revk/ESP32-Remote/PCB/Remote/README.md

# Remote

## Trademark

This project is subject to the licence in the LICENCE file, and even if that says it is an open source project, you cannot sell boards or cases bearing the Andrews & Arnold Ltd name, the A&A logo, the registered trademark AJK logo or other registered trademarks, or any GS1 allocated EANs/barcode assigned to Andrews & Arnold Ltd.

## PCB Designs

These files are for use with [KiCAD](https://www.kicad.org).

- [Remote](Remote.kicad_pro)

## 3D

3D case designs are normally automatically created from the PCB so as to ensure correct details and placement of apertures, etc.

- [blankplate](blankplate.stl)
- [Knob](Knob.stl)
- [Remote------](Remote------.stl)
- [Remote-----B](Remote-----B.stl)
- [Remote----I-](Remote----I-.stl)
- [Remote----IB](Remote----IB.stl)
- [Remote---C--](Remote---C--.stl)
- [Remote---C-B](Remote---C-B.stl)
- [Remote---CI-](Remote---CI-.stl)
- [Remote---CIB](Remote---CIB.stl)
- [Remote--D---](Remote--D---.stl)
- [Remote--D--B](Remote--D--B.stl)
- [Remote--D-I-](Remote--D-I-.stl)
- [Remote--D-IB](Remote--D-IB.stl)
- [Remote--DC--](Remote--DC--.stl)
- [Remote--DC-B](Remote--DC-B.stl)
- [Remote--DCI-](Remote--DCI-.stl)
- [Remote--DCIB](Remote--DCIB.stl)
- [Remote-Base](Remote-Base.stl)
- [Remote-P----](Remote-P----.stl)
- [Remote-P---B](Remote-P---B.stl)
- [Remote-P--I-](Remote-P--I-.stl)
- [Remote-P--IB](Remote-P--IB.stl)
- [Remote-P-C--](Remote-P-C--.stl)
- [Remote-P-C-B](Remote-P-C-B.stl)
- [Remote-P-CI-](Remote-P-CI-.stl)
- [Remote-P-CIB](Remote-P-CIB.stl)
- [Remote-PD---](Remote-PD---.stl)
- [Remote-PD--B](Remote-PD--B.stl)
- [Remote-PD-I-](Remote-PD-I-.stl)
- [Remote-PD-IB](Remote-PD-IB.stl)
- [Remote-PDC--](Remote-PDC--.stl)
- [Remote-PDC-B](Remote-PDC-B.stl)
- [Remote-PDCI-](Remote-PDCI-.stl)
- [Remote-PDCIB](Remote-PDCIB.stl)

## PCB Images

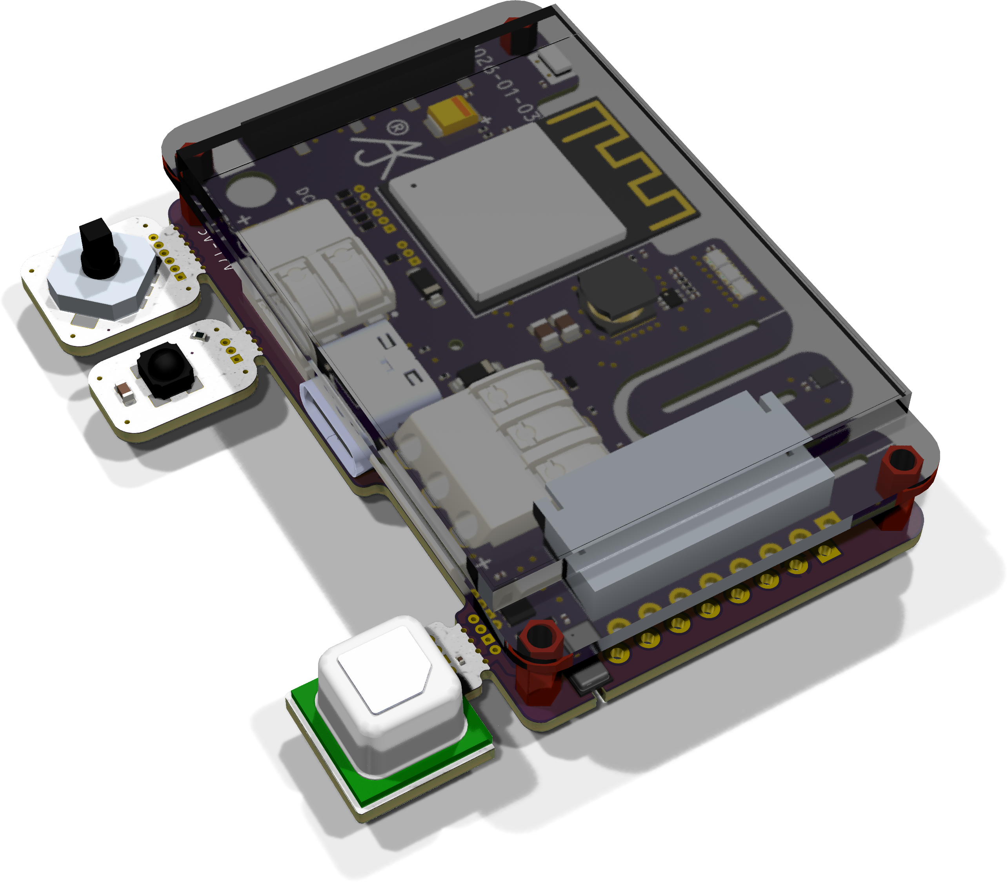
[picture p2: PCB/Remote/Remote-90.png]
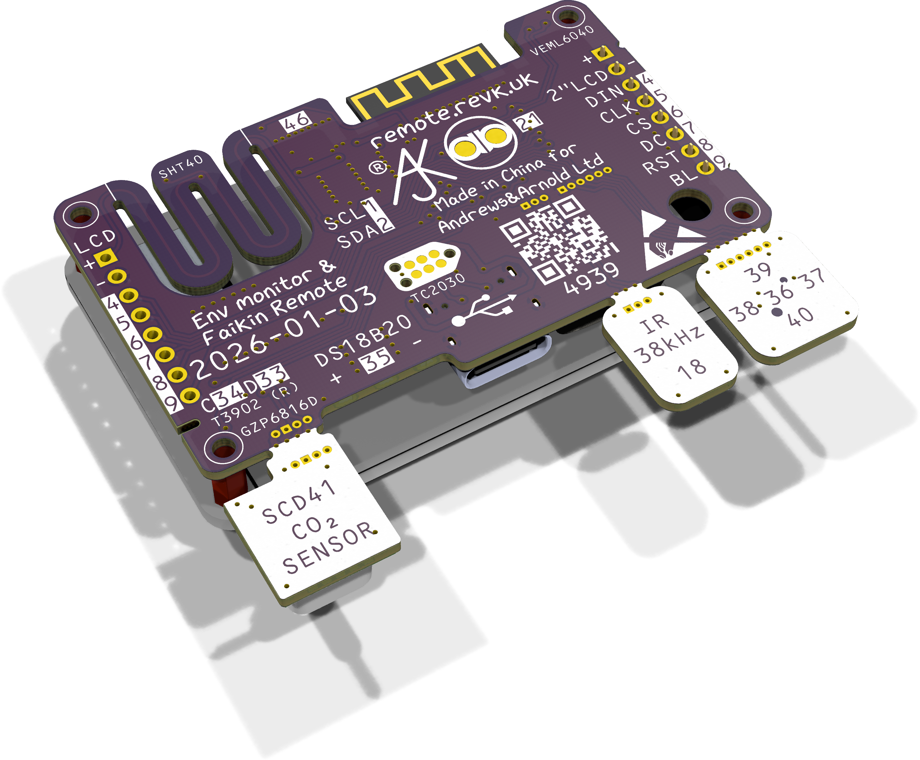
[picture p3: PCB/Remote/Remote-bottom.png]

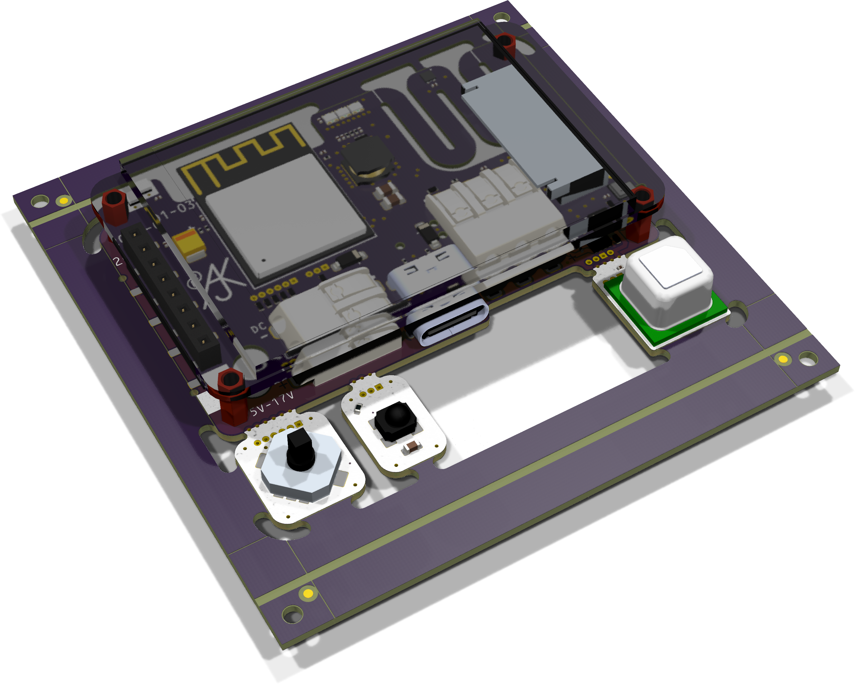
[picture p4: PCB/Remote/Remote-panel.png]
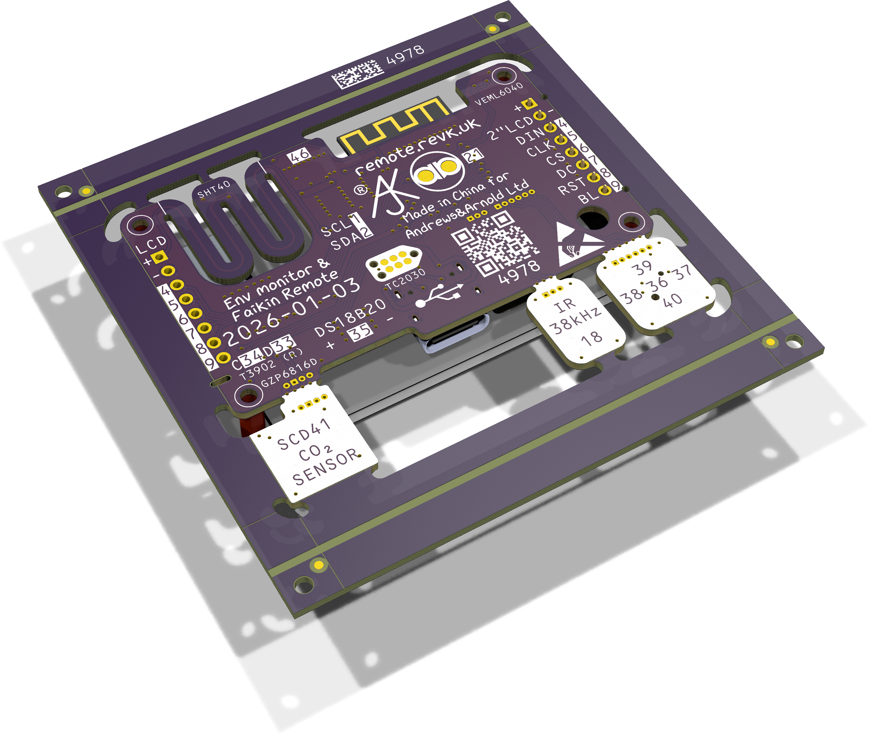
[picture p5: PCB/Remote/Remote-panel-bottom.png]


---

*Auto generated README.md 2026-01-03T10:27:57*
