revk/ESP32-Remote/PCB/Remote/blankplate.png

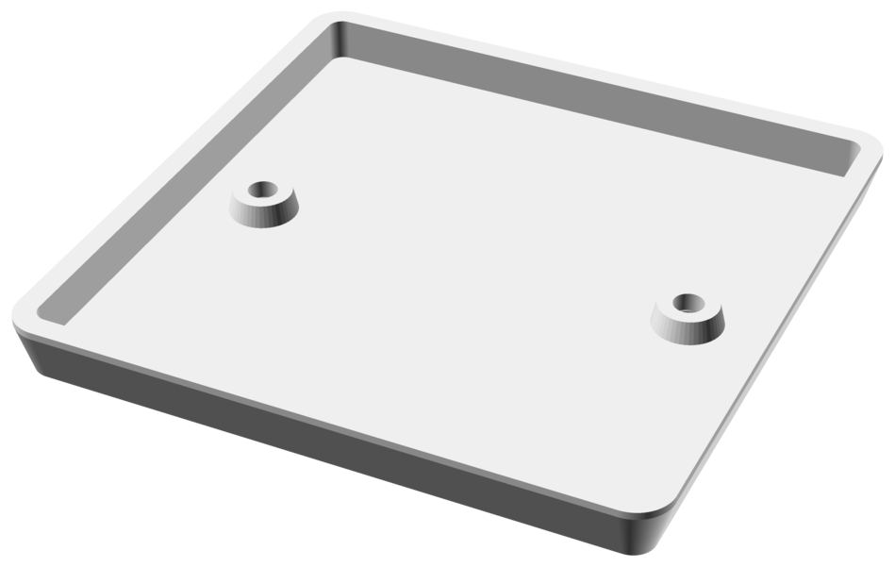
PCB/Remote/blankplate.png
