revk/ESP32-Remote/PCB/Remote/Knob.png

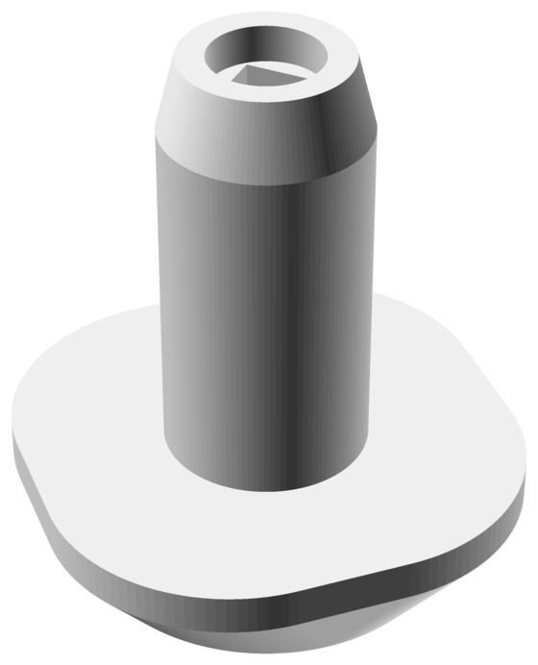
PCB/Remote/Knob.png
