revk/ESP32-Remote/PCB/Remote/Remote------.png

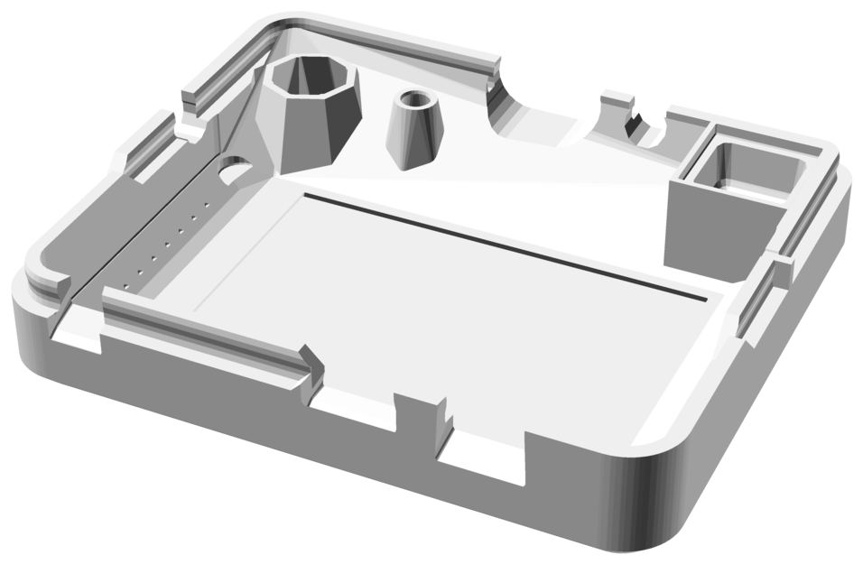
PCB/Remote/Remote------.png
