revk/ESP32-Remote/PCB/Remote/Remote-Base.png

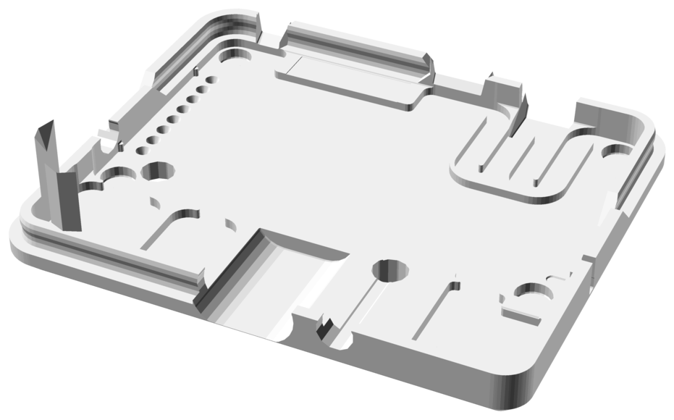
PCB/Remote/Remote-Base.png
