revk/ESP32-Remote/PCB/Remote/Remote-P----.png

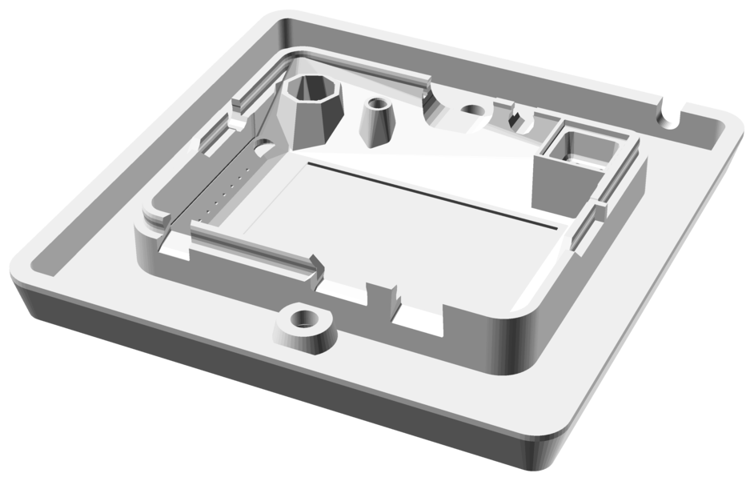
PCB/Remote/Remote-P----.png
