revk/ESP32-Remote/PCB/Remote/Remote-----B.stl

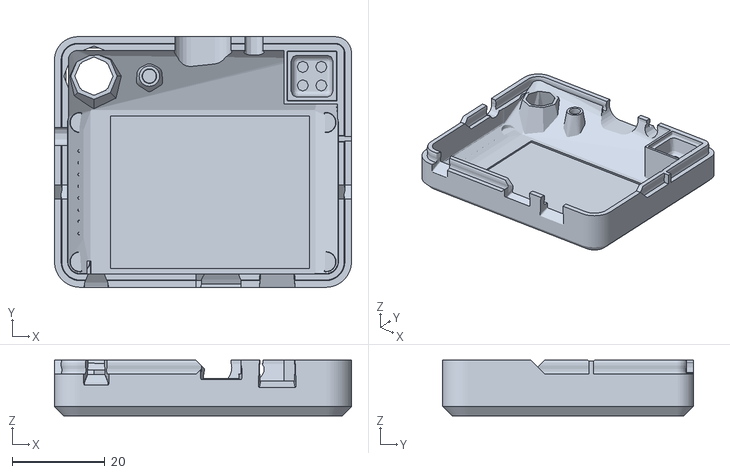
[picture p11: CAD file, 2026-01-03]
PCB/Remote/Remote-----B.stl
64.0 x 54.0 x 12.0
