revk/ESP32-Remote/PCB/Remote/Remote-P-C-B.stl

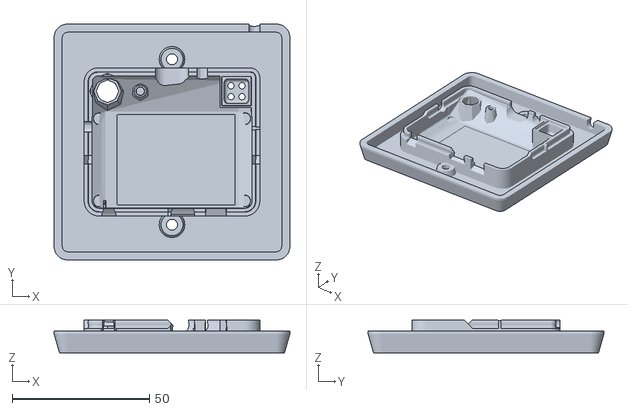
[picture p12: CAD file, 2026-01-03]
PCB/Remote/Remote-P-C-B.stl
86.0 x 86.0 x 12.0
