revk/ESP32-Remote/PCB/Remote/Remote--DCIB.stl

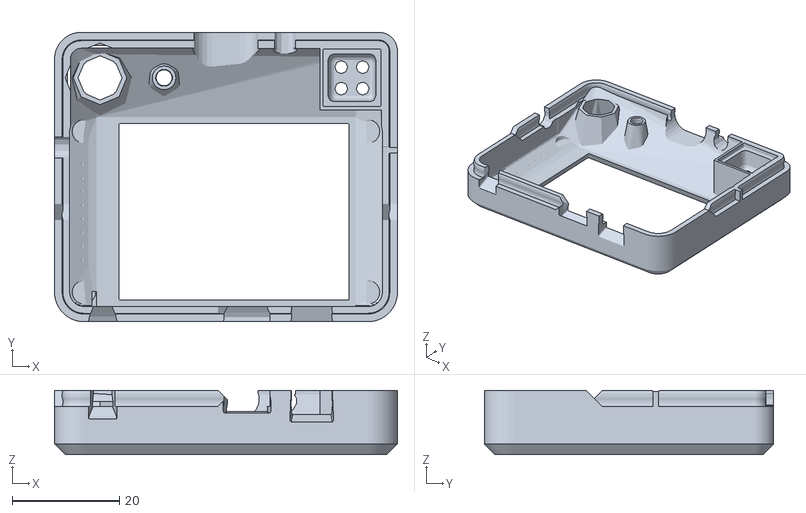
[picture p13: CAD file, 2026-01-03]
PCB/Remote/Remote--DCIB.stl
64.0 x 54.0 x 12.0
