revk/ESP32-Remote/PCB/Remote/Remote--D-I-.stl

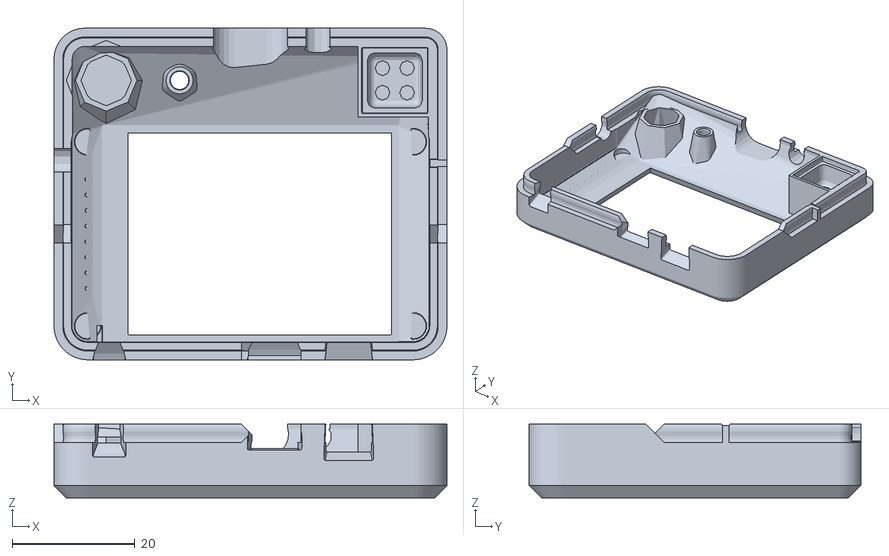
[picture p14: CAD file, 2026-01-03]
PCB/Remote/Remote--D-I-.stl
64.0 x 54.0 x 12.0
