revk/ESP32-Remote/PCB/Remote/Remote-PDC-B.stl

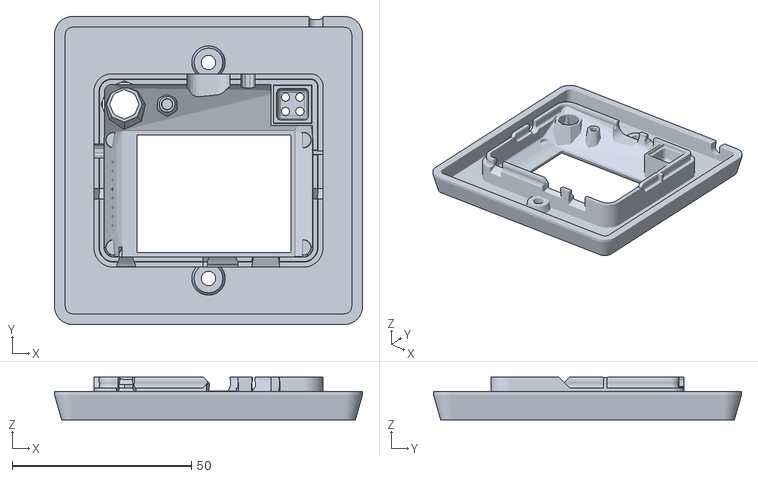
[picture p15: CAD file, 2026-01-03]
PCB/Remote/Remote-PDC-B.stl
86.0 x 86.0 x 12.0
