revk/ESP32-Remote/PCB/Remote/Remote-Base.stl

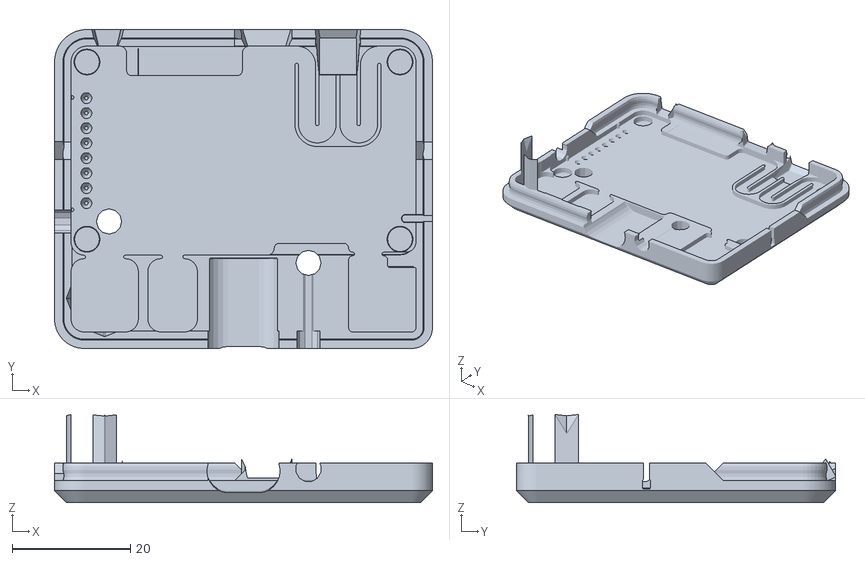
[picture p16: CAD file, 2026-01-03]
PCB/Remote/Remote-Base.stl
64.0 x 54.0 x 14.9
