revk/ESP32-Remote/PCB/Remote/Remote--DC--.stl

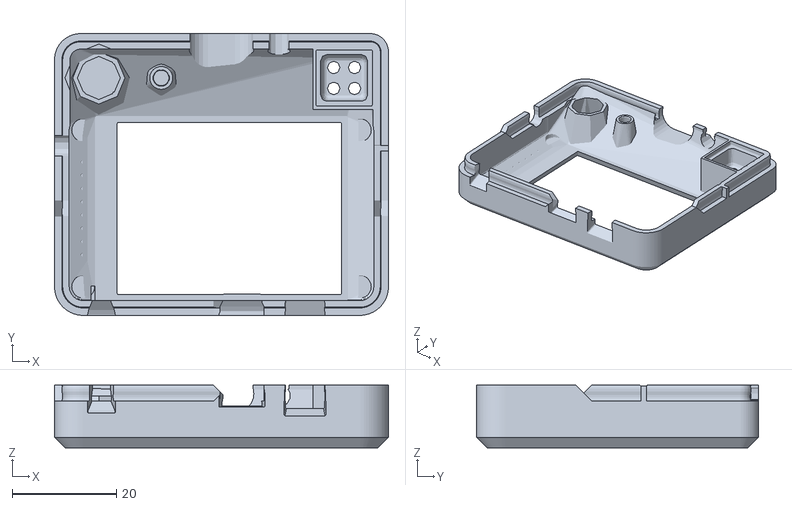
[picture p17: CAD file, 2026-01-03]
PCB/Remote/Remote--DC--.stl
64.0 x 54.0 x 12.0
