revk/ESP32-Remote/PCB/Remote/blankplate.stl

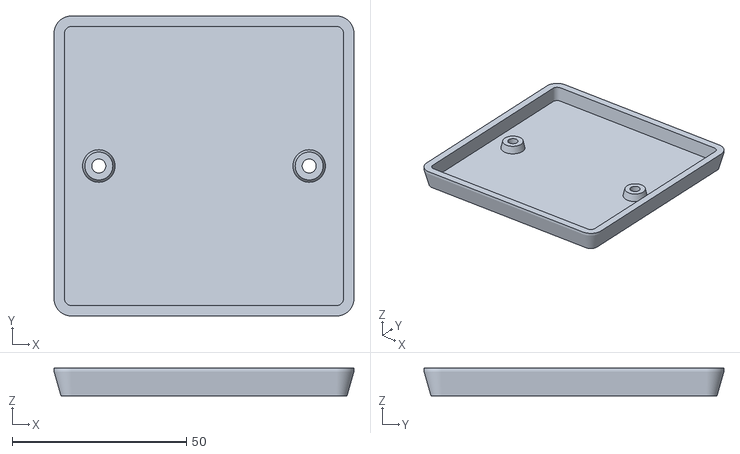
[picture p18: CAD file, 2025-08-25]
PCB/Remote/blankplate.stl
86.0 x 86.0 x 8.00
