revk/ESP32-Remote/PCB/Remote/Knob.stl

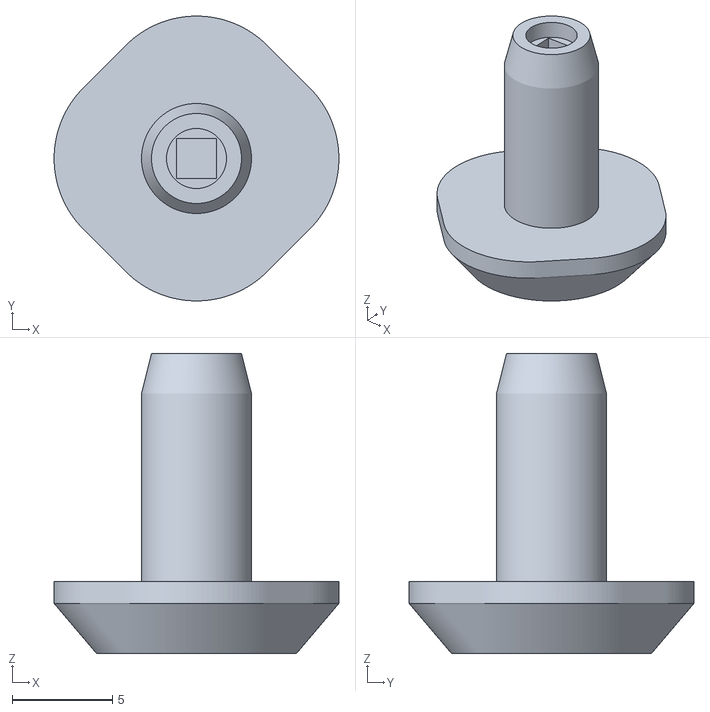
[picture p19: CAD file, 2025-08-25]
PCB/Remote/Knob.stl
14.2 x 14.2 x 15.0
