revk/ESP32-Remote/PCB/Remote/Knob.scad

$fn=120;
H=15;
m=0; // 0.3; // Zero for resin
difference()
{
    union()
    {
        hull()
        {
             cylinder(d=10,h=1);
             rotate([0,0,45])translate([0,0,3])minkowski()
             {
                cube([3,3,1],center=true);
                cylinder(r=5,h=0.1);
             }
        }
        cylinder(d=5.5,h=H-2);
        translate([0,0,H-2])cylinder(d2=4.5,d1=5.5,h=2);
    }
    translate([0,0,H-2])cube([2+m,2+m,4],center=true);
    translate([0,0,H-1])cylinder(d=3+m,h=2);
}
