revk/ESP32-Remote/PCB/Remote/Remote------.scad

// Generated case design for Remote/Remote.kicad_pcb
// By https://github.com/revk/PCBCase
// Generated 2026-01-03 10:10:24
// title:	Remote
// comment:	www.me.uk
// comment:	@TheRealRevK
// comment:	Adrian Kennard Andrews & Arnold Ltd
//

// Globals
margin=0.200000;
lip=3.000000;
lipa=0;
lipt=2;
casewall=3.000000;
casebottom=2.500000;
casetop=12.000000;
bottomthickness=0.000000;
topthickness=0.000000;
fit=0.000000;
snap=0.150000;
edge=2.000000;
pcbthickness=1.200000;
function pcbthickness()=1.200000;
nohull=false;
hullcap=1.000000;
hulledge=1.000000;
useredge=false;
datex=0.000000;
datey=0.000000;
datet=0.500000;
dateh=3.000000;
datea=0;
date="2026-01-03";
datef="OCRB";
logox=0.000000;
logoy=0.000000;
logot=0.500000;
logoh=10.000000;
logoa=0;
logo="A";
logof="AJK";
spacing=74.000000;
pcbwidth=58.000000;
function pcbwidth()=58.000000;
pcblength=48.000000;
function pcblength()=48.000000;
originx=100.000000;
originy=92.500000;

module outline(h=pcbthickness,r=0){linear_extrude(height=h)offset(r=r)polygon(points=[[20.000000,4.500000],[20.000000,14.500000],[20.036935,14.969303],[20.146831,15.427051],[20.326981,15.861971],[20.572949,16.263355],[20.878680,16.621320],[21.236645,16.927051],[21.638029,17.173019],[22.072949,17.353169],[22.530697,17.463065],[23.000000,17.500000],[26.500000,17.500000],[26.934120,17.462019],[27.355050,17.349232],[27.750000,17.165064],[28.106969,16.915111],[28.415111,16.606969],[28.665064,16.250000],[28.849232,15.855050],[28.962019,15.434120],[29.000000,15.000000],[29.000000,-15.500000],[28.962392,-15.833781],[28.851453,-16.150826],[28.672747,-16.435235],[28.435235,-16.672747],[28.150826,-16.851453],[27.833781,-16.962392],[27.500000,-17.000000],[23.700000,-17.000000],[23.450000,-17.066987],[23.266987,-17.250000],[23.200000,-17.500000],[23.266987,-17.750000],[23.450000,-17.933013],[23.700000,-18.000000],[23.891342,-18.038061],[24.053553,-18.146447],[24.161939,-18.308658],[24.200000,-18.500000],[24.200000,-19.500000],[24.346447,-19.853553],[24.700000,-20.000000],[29.000000,-20.000000],[29.000000,-30.000000],[28.961939,-30.191342],[28.853553,-30.353553],[28.691342,-30.461939],[28.500000,-30.500000],[18.500000,-30.500000],[18.308658,-30.461939],[18.146447,-30.353553],[18.038061,-30.191342],[18.000000,-30.000000],[18.000000,-18.500000],[18.038061,-18.308658],[18.146447,-18.146447],[18.308658,-18.038061],[18.500000,-18.000000],[18.750000,-17.933013],[18.933013,-17.750000],[19.000000,-17.500000],[18.933013,-17.250000],[18.750000,-17.066987],[18.500000,-17.000000],[18.308658,-16.961939],[18.146447,-16.853553],[18.038061,-16.691342],[18.000000,-16.500000],[17.923880,-16.117316],[17.707107,-15.792893],[17.382684,-15.576120],[17.000000,-15.500000],[6.000000,-15.500000],[5.617316,-15.576120],[5.292893,-15.792893],[5.076120,-16.117316],[5.000000,-16.500000],[4.965926,-16.758819],[4.866026,-17.000000],[4.707107,-17.207107],[4.500000,-17.366026],[4.258819,-17.465926],[4.000000,-17.500000],[-10.000000,-17.500000],[-10.250000,-17.566987],[-10.433013,-17.750000],[-10.500000,-18.000000],[-10.433013,-18.250000],[-10.250000,-18.433013],[-10.000000,-18.500000],[-9.609819,-18.538429],[-9.234633,-18.652241],[-8.888859,-18.837060],[-8.585786,-19.085786],[-8.337060,-19.388859],[-8.152241,-19.734633],[-8.038429,-20.109819],[-8.000000,-20.500000],[-8.000000,-28.500000],[-8.038429,-28.890181],[-8.152241,-29.265367],[-8.337060,-29.611141],[-8.585786,-29.914214],[-8.888859,-30.162940],[-9.234633,-30.347759],[-9.609819,-30.461571],[-10.000000,-30.500000],[-14.000000,-30.500000],[-14.390181,-30.461571],[-14.765367,-30.347759],[-15.111141,-30.162940],[-15.414214,-29.914214],[-15.662940,-29.611141],[-15.847759,-29.265367],[-15.961571,-28.890181],[-16.000000,-28.500000],[-16.000000,-20.500000],[-15.961571,-20.109819],[-15.847759,-19.734633],[-15.662940,-19.388859],[-15.414214,-19.085786],[-15.111141,-18.837060],[-14.765367,-18.652241],[-14.390181,-18.538429],[-14.000000,-18.500000],[-13.750000,-18.433013],[-13.566987,-18.250000],[-13.500000,-18.000000],[-13.566987,-17.750000],[-13.750000,-17.566987],[-14.000000,-17.500000],[-20.000000,-17.500000],[-20.250000,-17.566987],[-20.433013,-17.750000],[-20.500000,-18.000000],[-20.433013,-18.250000],[-20.250000,-18.433013],[-20.000000,-18.500000],[-19.609819,-18.538429],[-19.234633,-18.652241],[-18.888859,-18.837060],[-18.585786,-19.085786],[-18.337060,-19.388859],[-18.152241,-19.734633],[-18.038429,-20.109819],[-18.000000,-20.500000],[-18.000000,-28.500000],[-18.038429,-28.890181],[-18.152241,-29.265367],[-18.337060,-29.611141],[-18.585786,-29.914214],[-18.888859,-30.162940],[-19.234633,-30.347759],[-19.609819,-30.461571],[-20.000000,-30.500000],[-27.000000,-30.500000],[-27.390181,-30.461571],[-27.765367,-30.347759],[-28.111141,-30.162940],[-28.414214,-29.914214],[-28.662940,-29.611141],[-28.847759,-29.265367],[-28.961571,-28.890181],[-29.000000,-28.500000],[-29.000000,-20.500000],[-28.961571,-20.109819],[-28.847759,-19.734633],[-28.662940,-19.388859],[-28.414214,-19.085786],[-28.111141,-18.837060],[-27.765367,-18.652241],[-27.390181,-18.538429],[-27.000000,-18.500000],[-26.750000,-18.433013],[-26.566987,-18.250000],[-26.500000,-18.000000],[-26.566987,-17.750000],[-26.750000,-17.566987],[-27.000000,-17.500000],[-27.390181,-17.461571],[-27.765367,-17.347759],[-28.111141,-17.162940],[-28.414214,-16.914214],[-28.662940,-16.611141],[-28.847759,-16.265367],[-28.961571,-15.890181],[-29.000000,-15.500000],[-29.000000,-10.500000],[-28.750000,-10.433013],[-28.566987,-10.250000],[-28.500000,-10.000000],[-28.566987,-9.750000],[-28.750000,-9.566987],[-29.000000,-9.500000],[-29.000000,8.500000],[-28.750000,8.566987],[-28.566987,8.750000],[-28.500000,9.000000],[-28.566987,9.250000],[-28.750000,9.433013],[-29.000000,9.500000],[-29.000000,15.000000],[-28.962019,15.434120],[-28.849232,15.855050],[-28.665064,16.250000],[-28.415111,16.606969],[-28.106969,16.915111],[-27.750000,17.165064],[-27.355050,17.349232],[-26.934120,17.462019],[-26.500000,17.500000],[-21.000000,17.500000],[-20.741181,17.465926],[-20.500000,17.366026],[-20.292893,17.207107],[-20.133974,17.000000],[-20.034074,16.758819],[-20.000000,16.500000],[-20.000000,13.500000],[-19.923880,13.117316],[-19.707107,12.792893],[-19.382684,12.576120],[-19.000000,12.500000],[-1.000000,12.500000],[-0.617316,12.576120],[-0.292893,12.792893],[-0.076120,13.117316],[0.000000,13.500000],[0.000000,16.500000],[0.034074,16.758819],[0.133974,17.000000],[0.292893,17.207107],[0.500000,17.366026],[0.741181,17.465926],[1.000000,17.500000],[9.000000,17.500000],[9.469303,17.463065],[9.927051,17.353169],[10.361971,17.173019],[10.763355,16.927051],[11.121320,16.621320],[11.427051,16.263355],[11.673019,15.861971],[11.853169,15.427051],[11.963065,14.969303],[12.000000,14.500000],[12.000000,4.500000],[12.066987,4.250000],[12.250000,4.066987],[12.500000,4.000000],[12.750000,4.066987],[12.933013,4.250000],[13.000000,4.500000],[13.000000,15.500000],[13.038429,15.890181],[13.152241,16.265367],[13.337060,16.611141],[13.585786,16.914214],[13.888859,17.162940],[14.234633,17.347759],[14.609819,17.461571],[15.000000,17.500000],[17.000000,17.500000],[17.390181,17.461571],[17.765367,17.347759],[18.111141,17.162940],[18.414214,16.914214],[18.662940,16.611141],[18.847759,16.265367],[18.961571,15.890181],[19.000000,15.500000],[19.000000,4.500000],[19.066987,4.250000],[19.250000,4.066987],[19.500000,4.000000],[19.750000,4.066987],[19.933013,4.250000],[22.500000,4.500000],[22.500000,14.500000],[22.538060,14.691342],[22.646447,14.853553],[22.808658,14.961940],[23.000000,15.000000],[23.191342,14.961940],[23.353553,14.853553],[23.461940,14.691342],[23.500000,14.500000],[23.500000,4.500000],[23.465779,3.977895],[23.363703,3.464724],[23.195518,2.969266],[22.964101,2.500000],[22.673413,2.064954],[22.328427,1.671573],[21.935046,1.326587],[21.500000,1.035899],[21.030734,0.804482],[20.535276,0.636297],[20.022105,0.534221],[19.500000,0.500000],[12.500000,0.500000],[11.977895,0.534221],[11.464724,0.636297],[10.969266,0.804482],[10.500000,1.035899],[10.064954,1.326587],[9.671573,1.671573],[9.326587,2.064954],[9.035899,2.500000],[8.804482,2.969266],[8.636297,3.464724],[8.534221,3.977895],[8.500000,4.500000],[8.500000,14.500000],[8.538060,14.691342],[8.646447,14.853553],[8.808658,14.961940],[9.000000,15.000000],[9.191342,14.961940],[9.353553,14.853553],[9.461940,14.691342],[9.500000,14.500000],[9.500000,4.500000],[9.545577,3.979055],[9.680922,3.473940],[9.901924,3.000000],[10.201867,2.571637],[10.571637,2.201867],[11.000000,1.901924],[11.473940,1.680922],[11.979055,1.545577],[12.500000,1.500000],[13.020945,1.545577],[13.526060,1.680922],[14.000000,1.901924],[14.428363,2.201867],[14.798133,2.571637],[15.098076,3.000000],[15.319078,3.473940],[15.454423,3.979055],[15.500000,4.500000],[15.500000,13.000000],[15.538060,13.191342],[15.646447,13.353553],[15.808658,13.461940],[16.000000,13.500000],[16.191342,13.461940],[16.353553,13.353553],[16.461940,13.191342],[16.500000,13.000000],[16.500000,4.500000],[16.545577,3.979055],[16.680922,3.473940],[16.901924,3.000000],[17.201867,2.571637],[17.571637,2.201867],[18.000000,1.901924],[18.473940,1.680922],[18.979055,1.545577],[19.500000,1.500000],[20.020945,1.545577],[20.526060,1.680922],[21.000000,1.901924],[21.428363,2.201867],[21.798133,2.571637],[22.098076,3.000000],[22.319078,3.473940],[22.454423,3.979055],[25.500000,15.000000],[25.534074,15.258819],[25.633975,15.500000],[25.792893,15.707107],[26.000000,15.866025],[26.241181,15.965926],[26.500000,16.000000],[26.758819,15.965926],[27.000000,15.866025],[27.207107,15.707107],[27.366025,15.500000],[27.465926,15.258819],[27.500000,15.000000],[27.465926,14.741181],[27.366025,14.500000],[27.207107,14.292893],[27.000000,14.133975],[26.758819,14.034074],[26.500000,14.000000],[26.241181,14.034074],[26.000000,14.133975],[25.792893,14.292893],[25.633975,14.500000],[25.534074,14.741181],[25.500000,-15.000000],[25.534074,-14.741181],[25.633975,-14.500000],[25.792893,-14.292893],[26.000000,-14.133975],[26.241181,-14.034074],[26.500000,-14.000000],[26.758819,-14.034074],[27.000000,-14.133975],[27.207107,-14.292893],[27.366025,-14.500000],[27.465926,-14.741181],[27.500000,-15.000000],[27.465926,-15.258819],[27.366025,-15.500000],[27.207107,-15.707107],[27.000000,-15.866025],[26.758819,-15.965926],[26.500000,-16.000000],[26.241181,-15.965926],[26.000000,-15.866025],[25.792893,-15.707107],[25.633975,-15.500000],[25.534074,-15.258819],[-20.750000,-12.000000],[-20.788429,-12.390181],[-20.902241,-12.765367],[-21.087061,-13.111140],[-21.335786,-13.414214],[-21.638860,-13.662939],[-21.984633,-13.847759],[-22.359819,-13.961571],[-22.750000,-14.000000],[-23.140181,-13.961571],[-23.515367,-13.847759],[-23.861140,-13.662939],[-24.164214,-13.414214],[-24.412939,-13.111140],[-24.597759,-12.765367],[-24.711571,-12.390181],[-24.750000,-12.000000],[-24.711571,-11.609819],[-24.597759,-11.234633],[-24.412939,-10.888860],[-24.164214,-10.585786],[-23.861140,-10.337061],[-23.515367,-10.152241],[-23.140181,-10.038429],[-22.750000,-10.000000],[-22.359819,-10.038429],[-21.984633,-10.152241],[-21.638860,-10.337061],[-21.335786,-10.585786],[-21.087061,-10.888860],[-20.902241,-11.234633],[-20.788429,-11.609819],[-25.500000,-15.000000],[-25.534074,-15.258819],[-25.633975,-15.500000],[-25.792893,-15.707107],[-26.000000,-15.866025],[-26.241181,-15.965926],[-26.500000,-16.000000],[-26.758819,-15.965926],[-27.000000,-15.866025],[-27.207107,-15.707107],[-27.366025,-15.500000],[-27.465926,-15.258819],[-27.500000,-15.000000],[-27.465926,-14.741181],[-27.366025,-14.500000],[-27.207107,-14.292893],[-27.000000,-14.133975],[-26.758819,-14.034074],[-26.500000,-14.000000],[-26.241181,-14.034074],[-26.000000,-14.133975],[-25.792893,-14.292893],[-25.633975,-14.500000],[-25.534074,-14.741181],[-25.500000,15.000000],[-25.534074,14.741181],[-25.633975,14.500000],[-25.792893,14.292893],[-26.000000,14.133975],[-26.241181,14.034074],[-26.500000,14.000000],[-26.758819,14.034074],[-27.000000,14.133975],[-27.207107,14.292893],[-27.366025,14.500000],[-27.465926,14.741181],[-27.500000,15.000000],[-27.465926,15.258819],[-27.366025,15.500000],[-27.207107,15.707107],[-27.000000,15.866025],[-26.758819,15.965926],[-26.500000,16.000000],[-26.241181,15.965926],[-26.000000,15.866025],[-25.792893,15.707107],[-25.633975,15.500000],[-25.534074,15.258819]],paths=[[0,1,2,3,4,5,6,7,8,9,10,11,12,13,14,15,16,17,18,19,20,21,22,23,24,25,26,27,28,29,30,31,32,33,34,35,36,37,38,39,40,41,42,43,44,45,46,47,48,49,50,51,52,53,54,55,56,57,58,59,60,61,62,63,64,65,66,67,68,69,70,71,72,73,74,75,76,77,78,79,80,81,82,83,84,85,86,87,88,89,90,91,92,93,94,95,96,97,98,99,100,101,102,103,104,105,106,107,108,109,110,111,112,113,114,115,116,117,118,119,120,121,122,123,124,125,126,127,128,129,130,131,132,133,134,135,136,137,138,139,140,141,142,143,144,145,146,147,148,149,150,151,152,153,154,155,156,157,158,159,160,161,162,163,164,165,166,167,168,169,170,171,172,173,174,175,176,177,178,179,180,181,182,183,184,185,186,187,188,189,190,191,192,193,194,195,196,197,198,199,200,201,202,203,204,205,206,207,208,209,210,211,212,213,214,215,216,217,218,219,220,221,222,223,224,225,226,227,228,229,230,231,232,233,234,235,236,237,238,239,240,241,242,243,244,245,246,247,248,249,250,251,252,253,254,255,256,257,258,259,260,261,262,263,264,265,266,267,268,269,270,271,272,273,274,275,276,277,278],[279,280,281,282,283,284,285,286,287,288,289,290,291,292,293,294,295,296,297,298,299,300,301,302,303,304,305,306,307,308,309,310,311,312,313,314,315,316,317,318,319,320,321,322,323,324,325,326,327,328,329,330,331,332,333,334,335,336,337,338,339,340,341,342,343,344,345,346,347,348,349,350,351,352,353,354,355,356,357,358,359,360,361,362,363,364,365,366,367,368,369],[370,371,372,373,374,375,376,377,378,379,380,381,382,383,384,385,386,387,388,389,390,391,392,393],[394,395,396,397,398,399,400,401,402,403,404,405,406,407,408,409,410,411,412,413,414,415,416,417],[418,419,420,421,422,423,424,425,426,427,428,429,430,431,432,433,434,435,436,437,438,439,440,441,442,443,444,445,446,447,448,449],[450,451,452,453,454,455,456,457,458,459,460,461,462,463,464,465,466,467,468,469,470,471,472,473],[474,475,476,477,478,479,480,481,482,483,484,485,486,487,488,489,490,491,492,493,494,495,496,497]]);}

module pcb(h=pcbthickness,r=0){linear_extrude(height=h)offset(r=r)polygon(points=[[20.000000,4.500000],[20.000000,14.500000],[20.036935,14.969303],[20.146831,15.427051],[20.326981,15.861971],[20.572949,16.263355],[20.878680,16.621320],[21.236645,16.927051],[21.638029,17.173019],[22.072949,17.353169],[22.530697,17.463065],[23.000000,17.500000],[26.500000,17.500000],[26.934120,17.462019],[27.355050,17.349232],[27.750000,17.165064],[28.106969,16.915111],[28.415111,16.606969],[28.665064,16.250000],[28.849232,15.855050],[28.962019,15.434120],[29.000000,15.000000],[29.000000,-15.500000],[28.962392,-15.833781],[28.851453,-16.150826],[28.672747,-16.435235],[28.435235,-16.672747],[28.150826,-16.851453],[27.833781,-16.962392],[27.500000,-17.000000],[23.700000,-17.000000],[23.450000,-17.066987],[23.266987,-17.250000],[23.200000,-17.500000],[23.266987,-17.750000],[23.450000,-17.933013],[23.700000,-18.000000],[23.891342,-18.038061],[24.053553,-18.146447],[24.161939,-18.308658],[24.200000,-18.500000],[24.200000,-19.500000],[24.346447,-19.853553],[24.700000,-20.000000],[29.000000,-20.000000],[29.000000,-30.000000],[28.961939,-30.191342],[28.853553,-30.353553],[28.691342,-30.461939],[28.500000,-30.500000],[18.500000,-30.500000],[18.308658,-30.461939],[18.146447,-30.353553],[18.038061,-30.191342],[18.000000,-30.000000],[18.000000,-18.500000],[18.038061,-18.308658],[18.146447,-18.146447],[18.308658,-18.038061],[18.500000,-18.000000],[18.750000,-17.933013],[18.933013,-17.750000],[19.000000,-17.500000],[18.933013,-17.250000],[18.750000,-17.066987],[18.500000,-17.000000],[18.308658,-16.961939],[18.146447,-16.853553],[18.038061,-16.691342],[18.000000,-16.500000],[17.923880,-16.117316],[17.707107,-15.792893],[17.382684,-15.576120],[17.000000,-15.500000],[6.000000,-15.500000],[5.617316,-15.576120],[5.292893,-15.792893],[5.076120,-16.117316],[5.000000,-16.500000],[4.965926,-16.758819],[4.866026,-17.000000],[4.707107,-17.207107],[4.500000,-17.366026],[4.258819,-17.465926],[4.000000,-17.500000],[-10.000000,-17.500000],[-10.250000,-17.566987],[-10.433013,-17.750000],[-10.500000,-18.000000],[-10.433013,-18.250000],[-10.250000,-18.433013],[-10.000000,-18.500000],[-9.609819,-18.538429],[-9.234633,-18.652241],[-8.888859,-18.837060],[-8.585786,-19.085786],[-8.337060,-19.388859],[-8.152241,-19.734633],[-8.038429,-20.109819],[-8.000000,-20.500000],[-8.000000,-28.500000],[-8.038429,-28.890181],[-8.152241,-29.265367],[-8.337060,-29.611141],[-8.585786,-29.914214],[-8.888859,-30.162940],[-9.234633,-30.347759],[-9.609819,-30.461571],[-10.000000,-30.500000],[-14.000000,-30.500000],[-14.390181,-30.461571],[-14.765367,-30.347759],[-15.111141,-30.162940],[-15.414214,-29.914214],[-15.662940,-29.611141],[-15.847759,-29.265367],[-15.961571,-28.890181],[-16.000000,-28.500000],[-16.000000,-20.500000],[-15.961571,-20.109819],[-15.847759,-19.734633],[-15.662940,-19.388859],[-15.414214,-19.085786],[-15.111141,-18.837060],[-14.765367,-18.652241],[-14.390181,-18.538429],[-14.000000,-18.500000],[-13.750000,-18.433013],[-13.566987,-18.250000],[-13.500000,-18.000000],[-13.566987,-17.750000],[-13.750000,-17.566987],[-14.000000,-17.500000],[-20.000000,-17.500000],[-20.250000,-17.566987],[-20.433013,-17.750000],[-20.500000,-18.000000],[-20.433013,-18.250000],[-20.250000,-18.433013],[-20.000000,-18.500000],[-19.609819,-18.538429],[-19.234633,-18.652241],[-18.888859,-18.837060],[-18.585786,-19.085786],[-18.337060,-19.388859],[-18.152241,-19.734633],[-18.038429,-20.109819],[-18.000000,-20.500000],[-18.000000,-28.500000],[-18.038429,-28.890181],[-18.152241,-29.265367],[-18.337060,-29.611141],[-18.585786,-29.914214],[-18.888859,-30.162940],[-19.234633,-30.347759],[-19.609819,-30.461571],[-20.000000,-30.500000],[-27.000000,-30.500000],[-27.390181,-30.461571],[-27.765367,-30.347759],[-28.111141,-30.162940],[-28.414214,-29.914214],[-28.662940,-29.611141],[-28.847759,-29.265367],[-28.961571,-28.890181],[-29.000000,-28.500000],[-29.000000,-20.500000],[-28.961571,-20.109819],[-28.847759,-19.734633],[-28.662940,-19.388859],[-28.414214,-19.085786],[-28.111141,-18.837060],[-27.765367,-18.652241],[-27.390181,-18.538429],[-27.000000,-18.500000],[-26.750000,-18.433013],[-26.566987,-18.250000],[-26.500000,-18.000000],[-26.566987,-17.750000],[-26.750000,-17.566987],[-27.000000,-17.500000],[-27.390181,-17.461571],[-27.765367,-17.347759],[-28.111141,-17.162940],[-28.414214,-16.914214],[-28.662940,-16.611141],[-28.847759,-16.265367],[-28.961571,-15.890181],[-29.000000,-15.500000],[-29.000000,-10.500000],[-28.750000,-10.433013],[-28.566987,-10.250000],[-28.500000,-10.000000],[-28.566987,-9.750000],[-28.750000,-9.566987],[-29.000000,-9.500000],[-29.000000,8.500000],[-28.750000,8.566987],[-28.566987,8.750000],[-28.500000,9.000000],[-28.566987,9.250000],[-28.750000,9.433013],[-29.000000,9.500000],[-29.000000,15.000000],[-28.962019,15.434120],[-28.849232,15.855050],[-28.665064,16.250000],[-28.415111,16.606969],[-28.106969,16.915111],[-27.750000,17.165064],[-27.355050,17.349232],[-26.934120,17.462019],[-26.500000,17.500000],[-21.000000,17.500000],[-20.741181,17.465926],[-20.500000,17.366026],[-20.292893,17.207107],[-20.133974,17.000000],[-20.034074,16.758819],[-20.000000,16.500000],[-20.000000,13.500000],[-19.923880,13.117316],[-19.707107,12.792893],[-19.382684,12.576120],[-19.000000,12.500000],[-1.000000,12.500000],[-0.617316,12.576120],[-0.292893,12.792893],[-0.076120,13.117316],[0.000000,13.500000],[0.000000,16.500000],[0.034074,16.758819],[0.133974,17.000000],[0.292893,17.207107],[0.500000,17.366026],[0.741181,17.465926],[1.000000,17.500000],[9.000000,17.500000],[9.469303,17.463065],[9.927051,17.353169],[10.361971,17.173019],[10.763355,16.927051],[11.121320,16.621320],[11.427051,16.263355],[11.673019,15.861971],[11.853169,15.427051],[11.963065,14.969303],[12.000000,14.500000],[12.000000,4.500000],[12.066987,4.250000],[12.250000,4.066987],[12.500000,4.000000],[12.750000,4.066987],[12.933013,4.250000],[13.000000,4.500000],[13.000000,15.500000],[13.038429,15.890181],[13.152241,16.265367],[13.337060,16.611141],[13.585786,16.914214],[13.888859,17.162940],[14.234633,17.347759],[14.609819,17.461571],[15.000000,17.500000],[17.000000,17.500000],[17.390181,17.461571],[17.765367,17.347759],[18.111141,17.162940],[18.414214,16.914214],[18.662940,16.611141],[18.847759,16.265367],[18.961571,15.890181],[19.000000,15.500000],[19.000000,4.500000],[19.066987,4.250000],[19.250000,4.066987],[19.500000,4.000000],[19.750000,4.066987],[19.933013,4.250000],[22.500000,4.500000],[22.500000,14.500000],[22.538060,14.691342],[22.646447,14.853553],[22.808658,14.961940],[23.000000,15.000000],[23.191342,14.961940],[23.353553,14.853553],[23.461940,14.691342],[23.500000,14.500000],[23.500000,4.500000],[23.465779,3.977895],[23.363703,3.464724],[23.195518,2.969266],[22.964101,2.500000],[22.673413,2.064954],[22.328427,1.671573],[21.935046,1.326587],[21.500000,1.035899],[21.030734,0.804482],[20.535276,0.636297],[20.022105,0.534221],[19.500000,0.500000],[12.500000,0.500000],[11.977895,0.534221],[11.464724,0.636297],[10.969266,0.804482],[10.500000,1.035899],[10.064954,1.326587],[9.671573,1.671573],[9.326587,2.064954],[9.035899,2.500000],[8.804482,2.969266],[8.636297,3.464724],[8.534221,3.977895],[8.500000,4.500000],[8.500000,14.500000],[8.538060,14.691342],[8.646447,14.853553],[8.808658,14.961940],[9.000000,15.000000],[9.191342,14.961940],[9.353553,14.853553],[9.461940,14.691342],[9.500000,14.500000],[9.500000,4.500000],[9.545577,3.979055],[9.680922,3.473940],[9.901924,3.000000],[10.201867,2.571637],[10.571637,2.201867],[11.000000,1.901924],[11.473940,1.680922],[11.979055,1.545577],[12.500000,1.500000],[13.020945,1.545577],[13.526060,1.680922],[14.000000,1.901924],[14.428363,2.201867],[14.798133,2.571637],[15.098076,3.000000],[15.319078,3.473940],[15.454423,3.979055],[15.500000,4.500000],[15.500000,13.000000],[15.538060,13.191342],[15.646447,13.353553],[15.808658,13.461940],[16.000000,13.500000],[16.191342,13.461940],[16.353553,13.353553],[16.461940,13.191342],[16.500000,13.000000],[16.500000,4.500000],[16.545577,3.979055],[16.680922,3.473940],[16.901924,3.000000],[17.201867,2.571637],[17.571637,2.201867],[18.000000,1.901924],[18.473940,1.680922],[18.979055,1.545577],[19.500000,1.500000],[20.020945,1.545577],[20.526060,1.680922],[21.000000,1.901924],[21.428363,2.201867],[21.798133,2.571637],[22.098076,3.000000],[22.319078,3.473940],[22.454423,3.979055],[25.500000,15.000000],[25.534074,15.258819],[25.633975,15.500000],[25.792893,15.707107],[26.000000,15.866025],[26.241181,15.965926],[26.500000,16.000000],[26.758819,15.965926],[27.000000,15.866025],[27.207107,15.707107],[27.366025,15.500000],[27.465926,15.258819],[27.500000,15.000000],[27.465926,14.741181],[27.366025,14.500000],[27.207107,14.292893],[27.000000,14.133975],[26.758819,14.034074],[26.500000,14.000000],[26.241181,14.034074],[26.000000,14.133975],[25.792893,14.292893],[25.633975,14.500000],[25.534074,14.741181],[25.500000,-15.000000],[25.534074,-14.741181],[25.633975,-14.500000],[25.792893,-14.292893],[26.000000,-14.133975],[26.241181,-14.034074],[26.500000,-14.000000],[26.758819,-14.034074],[27.000000,-14.133975],[27.207107,-14.292893],[27.366025,-14.500000],[27.465926,-14.741181],[27.500000,-15.000000],[27.465926,-15.258819],[27.366025,-15.500000],[27.207107,-15.707107],[27.000000,-15.866025],[26.758819,-15.965926],[26.500000,-16.000000],[26.241181,-15.965926],[26.000000,-15.866025],[25.792893,-15.707107],[25.633975,-15.500000],[25.534074,-15.258819],[-20.750000,-12.000000],[-20.788429,-12.390181],[-20.902241,-12.765367],[-21.087061,-13.111140],[-21.335786,-13.414214],[-21.638860,-13.662939],[-21.984633,-13.847759],[-22.359819,-13.961571],[-22.750000,-14.000000],[-23.140181,-13.961571],[-23.515367,-13.847759],[-23.861140,-13.662939],[-24.164214,-13.414214],[-24.412939,-13.111140],[-24.597759,-12.765367],[-24.711571,-12.390181],[-24.750000,-12.000000],[-24.711571,-11.609819],[-24.597759,-11.234633],[-24.412939,-10.888860],[-24.164214,-10.585786],[-23.861140,-10.337061],[-23.515367,-10.152241],[-23.140181,-10.038429],[-22.750000,-10.000000],[-22.359819,-10.038429],[-21.984633,-10.152241],[-21.638860,-10.337061],[-21.335786,-10.585786],[-21.087061,-10.888860],[-20.902241,-11.234633],[-20.788429,-11.609819],[-25.500000,-15.000000],[-25.534074,-15.258819],[-25.633975,-15.500000],[-25.792893,-15.707107],[-26.000000,-15.866025],[-26.241181,-15.965926],[-26.500000,-16.000000],[-26.758819,-15.965926],[-27.000000,-15.866025],[-27.207107,-15.707107],[-27.366025,-15.500000],[-27.465926,-15.258819],[-27.500000,-15.000000],[-27.465926,-14.741181],[-27.366025,-14.500000],[-27.207107,-14.292893],[-27.000000,-14.133975],[-26.758819,-14.034074],[-26.500000,-14.000000],[-26.241181,-14.034074],[-26.000000,-14.133975],[-25.792893,-14.292893],[-25.633975,-14.500000],[-25.534074,-14.741181],[-25.500000,15.000000],[-25.534074,14.741181],[-25.633975,14.500000],[-25.792893,14.292893],[-26.000000,14.133975],[-26.241181,14.034074],[-26.500000,14.000000],[-26.758819,14.034074],[-27.000000,14.133975],[-27.207107,14.292893],[-27.366025,14.500000],[-27.465926,14.741181],[-27.500000,15.000000],[-27.465926,15.258819],[-27.366025,15.500000],[-27.207107,15.707107],[-27.000000,15.866025],[-26.758819,15.965926],[-26.500000,16.000000],[-26.241181,15.965926],[-26.000000,15.866025],[-25.792893,15.707107],[-25.633975,15.500000],[-25.534074,15.258819]],paths=[[0,1,2,3,4,5,6,7,8,9,10,11,12,13,14,15,16,17,18,19,20,21,22,23,24,25,26,27,28,29,30,31,32,33,34,35,36,37,38,39,40,41,42,43,44,45,46,47,48,49,50,51,52,53,54,55,56,57,58,59,60,61,62,63,64,65,66,67,68,69,70,71,72,73,74,75,76,77,78,79,80,81,82,83,84,85,86,87,88,89,90,91,92,93,94,95,96,97,98,99,100,101,102,103,104,105,106,107,108,109,110,111,112,113,114,115,116,117,118,119,120,121,122,123,124,125,126,127,128,129,130,131,132,133,134,135,136,137,138,139,140,141,142,143,144,145,146,147,148,149,150,151,152,153,154,155,156,157,158,159,160,161,162,163,164,165,166,167,168,169,170,171,172,173,174,175,176,177,178,179,180,181,182,183,184,185,186,187,188,189,190,191,192,193,194,195,196,197,198,199,200,201,202,203,204,205,206,207,208,209,210,211,212,213,214,215,216,217,218,219,220,221,222,223,224,225,226,227,228,229,230,231,232,233,234,235,236,237,238,239,240,241,242,243,244,245,246,247,248,249,250,251,252,253,254,255,256,257,258,259,260,261,262,263,264,265,266,267,268,269,270,271,272,273,274,275,276,277,278],[279,280,281,282,283,284,285,286,287,288,289,290,291,292,293,294,295,296,297,298,299,300,301,302,303,304,305,306,307,308,309,310,311,312,313,314,315,316,317,318,319,320,321,322,323,324,325,326,327,328,329,330,331,332,333,334,335,336,337,338,339,340,341,342,343,344,345,346,347,348,349,350,351,352,353,354,355,356,357,358,359,360,361,362,363,364,365,366,367,368,369],[370,371,372,373,374,375,376,377,378,379,380,381,382,383,384,385,386,387,388,389,390,391,392,393],[394,395,396,397,398,399,400,401,402,403,404,405,406,407,408,409,410,411,412,413,414,415,416,417],[418,419,420,421,422,423,424,425,426,427,428,429,430,431,432,433,434,435,436,437,438,439,440,441,442,443,444,445,446,447,448,449],[450,451,452,453,454,455,456,457,458,459,460,461,462,463,464,465,466,467,468,469,470,471,472,473],[474,475,476,477,478,479,480,481,482,483,484,485,486,487,488,489,490,491,492,493,494,495,496,497]]);}
module C8(){translate([0.925000,16.075000,1.200000])rotate([0,0,90.000000])children();}
module part_C8(part=true,hole=false,block=false)
{
translate([0.925000,16.075000,1.200000])rotate([0,0,90.000000])m0(part,hole,block,casetop); // RevK:C_0201 C_0201_0603Metric (back)
};
module R3(){translate([-1.250000,-8.300000,1.200000])rotate([0,0,90.000000])children();}
module part_R3(part=true,hole=false,block=false)
{
translate([-1.250000,-8.300000,1.200000])rotate([0,0,90.000000])m1(part,hole,block,casetop); // RevK:R_0201 R_0201_0603Metric (back)
};
module R11(){translate([2.600000,12.300000,1.200000])rotate([0,0,-90.000000])children();}
module part_R11(part=true,hole=false,block=false)
{
translate([2.600000,12.300000,1.200000])rotate([0,0,-90.000000])m1(part,hole,block,casetop); // RevK:R_0201 R_0201_0603Metric (back)
};
module SW1(){translate([-23.500000,-25.000000,1.200000])rotate([0,0,45.000000])children();}
module part_SW1(part=true,hole=false,block=false)
{
translate([-23.500000,-25.000000,1.200000])rotate([0,0,45.000000])m2(part,hole,block,casetop); // SW1
};
module D7(){translate([-15.500000,-5.900000,1.200000])rotate([0,0,-90.000000])children();}
module part_D7(part=true,hole=false,block=false)
{
translate([-15.500000,-5.900000,1.200000])rotate([0,0,-90.000000])m3(part,hole,block,casetop); // D7
};
module U8(){translate([-23.000000,16.500000,1.200000])children();}
module part_U8(part=true,hole=false,block=false)
{
translate([-23.000000,16.500000,1.200000])m4(part,hole,block,casetop); // U8
};
module TP24(){translate([-12.000000,-19.500000,1.200000])children();}
module part_TP24(part=true,hole=false,block=false)
{
};
module C3(){translate([-1.250000,11.250000,1.200000])children();}
module part_C3(part=true,hole=false,block=false)
{
translate([-1.250000,11.250000,1.200000])m0(part,hole,block,casetop); // RevK:C_0201 C_0201_0603Metric (back)
};
module D3(){translate([-14.500000,-5.900000,1.200000])rotate([0,0,-90.000000])children();}
module part_D3(part=true,hole=false,block=false)
{
translate([-14.500000,-5.900000,1.200000])rotate([0,0,-90.000000])m3(part,hole,block,casetop); // D7
};
module TP18(){translate([20.100000,-19.500000,1.200000])children();}
module part_TP18(part=true,hole=false,block=false)
{
};
module R9(){translate([-14.400000,-21.000000,1.200000])rotate([0,0,45.000000])children();}
module part_R9(part=true,hole=false,block=false)
{
translate([-14.400000,-21.000000,1.200000])rotate([0,0,45.000000])m5(part,hole,block,casetop); // RevK:R_0402 R_0402_1005Metric (back)
};
module C9(){translate([-21.400000,14.400000,1.200000])children();}
module part_C9(part=true,hole=false,block=false)
{
translate([-21.400000,14.400000,1.200000])m0(part,hole,block,casetop); // RevK:C_0201 C_0201_0603Metric (back)
};
module TP21(){translate([-10.500000,-4.500000,1.200000])children();}
module part_TP21(part=true,hole=false,block=false)
{
};
module TP10(){translate([-25.000000,-19.500000,1.200000])children();}
module part_TP10(part=true,hole=false,block=false)
{
};
module D8(){translate([-16.500000,-5.900000,1.200000])rotate([0,0,-90.000000])children();}
module part_D8(part=true,hole=false,block=false)
{
translate([-16.500000,-5.900000,1.200000])rotate([0,0,-90.000000])m3(part,hole,block,casetop); // D7
};
module TP20(){translate([21.100000,-19.500000,1.200000])children();}
module part_TP20(part=true,hole=false,block=false)
{
};
module D10(){translate([-18.500000,-5.900000,1.200000])rotate([0,0,-90.000000])children();}
module part_D10(part=true,hole=false,block=false)
{
translate([-18.500000,-5.900000,1.200000])rotate([0,0,-90.000000])m3(part,hole,block,casetop); // D7
};
module C1(){translate([-18.300000,9.100000,1.200000])rotate([0,0,-90.000000])children();}
module part_C1(part=true,hole=false,block=false)
{
translate([-18.300000,9.100000,1.200000])rotate([0,0,-90.000000])m0(part,hole,block,casetop); // RevK:C_0201 C_0201_0603Metric (back)
};
module TP25(){translate([-11.000000,-19.500000,1.200000])children();}
module part_TP25(part=true,hole=false,block=false)
{
};
module TP9(){translate([-24.000000,-19.500000,1.200000])children();}
module part_TP9(part=true,hole=false,block=false)
{
};
module TP8(){translate([-23.000000,-19.500000,1.200000])children();}
module part_TP8(part=true,hole=false,block=false)
{
};
module L2(){translate([2.200000,6.500000,1.200000])rotate([0,0,180.000000])children();}
module part_L2(part=true,hole=false,block=false)
{
translate([2.200000,6.500000,1.200000])rotate([0,0,180.000000])m6(part,hole,block,casetop); // L2
};
module R5(){translate([-1.250000,10.250000,1.200000])rotate([0,0,180.000000])children();}
module part_R5(part=true,hole=false,block=false)
{
translate([-1.250000,10.250000,1.200000])rotate([0,0,180.000000])m1(part,hole,block,casetop); // RevK:R_0201 R_0201_0603Metric (back)
};
module R7(){translate([-19.300000,7.400000,1.200000])rotate([0,0,-90.000000])children();}
module part_R7(part=true,hole=false,block=false)
{
translate([-19.300000,7.400000,1.200000])rotate([0,0,-90.000000])m1(part,hole,block,casetop); // RevK:R_0201 R_0201_0603Metric (back)
};
module TP16(){translate([21.100000,-15.900000,1.200000])children();}
module part_TP16(part=true,hole=false,block=false)
{
};
module TP23(){translate([-11.500000,-4.500000,1.200000])children();}
module part_TP23(part=true,hole=false,block=false)
{
};
module TP19(){translate([22.100000,-19.500000,1.200000])children();}
module part_TP19(part=true,hole=false,block=false)
{
};
module C10(){translate([19.300000,-13.900000,1.200000])rotate([0,0,-90.000000])children();}
module part_C10(part=true,hole=false,block=false)
{
translate([19.300000,-13.900000,1.200000])rotate([0,0,-90.000000])m0(part,hole,block,casetop); // RevK:C_0201 C_0201_0603Metric (back)
};
module TP15(){translate([22.100000,-15.900000,1.200000])children();}
module part_TP15(part=true,hole=false,block=false)
{
};
module C11(){translate([14.000000,-0.500000,1.200000])rotate([0,0,180.000000])children();}
module part_C11(part=true,hole=false,block=false)
{
translate([14.000000,-0.500000,1.200000])rotate([0,0,180.000000])m0(part,hole,block,casetop); // RevK:C_0201 C_0201_0603Metric (back)
};
module J1(){translate([0.000000,0.000000,1.200000])children();}
module part_J1(part=true,hole=false,block=false)
{
translate([0.000000,0.000000,1.200000])translate([0.000000,0.000000,8.300000])rotate([0.000000,180.000000,180.000000])m8(part,hole,block,casetop); // RevK:LCD2 WSLCD2 (back)
};
module D5(){translate([3.925000,15.800000,1.200000])rotate([0,0,90.000000])children();}
module part_D5(part=true,hole=false,block=false)
{
translate([3.925000,15.800000,1.200000])rotate([0,0,90.000000])m11(part,hole,block,casetop); // D5
};
module C23(){translate([2.000000,12.300000,1.200000])rotate([0,0,90.000000])children();}
module part_C23(part=true,hole=false,block=false)
{
translate([2.000000,12.300000,1.200000])rotate([0,0,90.000000])m0(part,hole,block,casetop); // RevK:C_0201 C_0201_0603Metric (back)
};
module D20(){translate([3.000000,-6.250000,1.200000])rotate([0,0,-90.000000])children();}
module part_D20(part=true,hole=false,block=false)
{
translate([3.000000,-6.250000,1.200000])rotate([0,0,-90.000000])m12(part,hole,block,casetop); // RevK:D_SOD-123FL D_SOD-123 (back)
};
module D6(){translate([2.175000,15.800000,1.200000])rotate([0,0,90.000000])children();}
module part_D6(part=true,hole=false,block=false)
{
translate([2.175000,15.800000,1.200000])rotate([0,0,90.000000])m11(part,hole,block,casetop); // D5
};
module D11(){translate([7.000000,-0.500000,1.200000])children();}
module part_D11(part=true,hole=false,block=false)
{
translate([7.000000,-0.500000,1.200000])m3(part,hole,block,casetop); // D7
};
module TP7(){translate([-22.000000,-19.500000,1.200000])children();}
module part_TP7(part=true,hole=false,block=false)
{
};
module C5(){translate([21.700000,-18.500000,1.200000])children();}
module part_C5(part=true,hole=false,block=false)
{
translate([21.700000,-18.500000,1.200000])m0(part,hole,block,casetop); // RevK:C_0201 C_0201_0603Metric (back)
};
module TP11(){translate([-26.000000,-19.500000,1.200000])children();}
module part_TP11(part=true,hole=false,block=false)
{
};
module C20(){translate([2.062500,0.200000,1.200000])rotate([0,0,180.000000])children();}
module part_C20(part=true,hole=false,block=false)
{
translate([2.062500,0.200000,1.200000])rotate([0,0,180.000000])m13(part,hole,block,casetop); // RevK:C_0805 C_0805_2012Metric (back)
};
module TP5(){translate([-18.500000,-4.500000,1.200000])children();}
module part_TP5(part=true,hole=false,block=false)
{
};
module R10(){translate([3.800000,12.300000,1.200000])rotate([0,0,90.000000])children();}
module part_R10(part=true,hole=false,block=false)
{
translate([3.800000,12.300000,1.200000])rotate([0,0,90.000000])m1(part,hole,block,casetop); // RevK:R_0201 R_0201_0603Metric (back)
};
module U2(){translate([23.500000,-25.000000,1.200000])rotate([0,0,-90.000000])children();}
module part_U2(part=true,hole=false,block=false)
{
translate([23.500000,-25.000000,1.200000])rotate([0,0,-90.000000])m14(part,hole,block,casetop); // U2
};
module U9(){translate([3.800000,10.512500,1.200000])rotate([0,0,90.000000])children();}
module part_U9(part=true,hole=false,block=false)
{
translate([3.800000,10.512500,1.200000])rotate([0,0,90.000000])m15(part,hole,block,casetop); // RevK:SOT-5x3-6 SOT-563 (back)
};
module C13(){translate([-12.000000,-28.500000,1.200000])children();}
module part_C13(part=true,hole=false,block=false)
{
translate([-12.000000,-28.500000,1.200000])m16(part,hole,block,casetop); // RevK:C_0603 C_0603_1608Metric (back)
};
module D12(){translate([-10.500000,-5.900000,1.200000])rotate([0,0,90.000000])children();}
module part_D12(part=true,hole=false,block=false)
{
translate([-10.500000,-5.900000,1.200000])rotate([0,0,90.000000])m3(part,hole,block,casetop); // D7
};
module J3(){translate([11.000000,-7.500000,1.200000])rotate([0,0,90.000000])children();}
module part_J3(part=true,hole=false,block=false)
{
translate([11.000000,-7.500000,1.200000])rotate([0,0,90.000000])m17(part,hole,block,casetop,453); // J3
};
module J6(){translate([0.000000,-11.570000,1.200000])children();}
module part_J6(part=true,hole=false,block=false)
{
translate([0.000000,-11.570000,1.200000])translate([0.000000,-1.900000,0.000000])rotate([90.000000,0.000000,0.000000])m18(part,hole,block,casetop); // RevK:USB-C-Socket-H CSP-USC16-TR (back)
};
module C4(){translate([-21.500000,5.837500,1.200000])rotate([0,0,90.000000])children();}
module part_C4(part=true,hole=false,block=false)
{
translate([-21.500000,5.837500,1.200000])rotate([0,0,90.000000])m19(part,hole,block,casetop); // C4
};
module TP13(){translate([19.100000,-15.900000,1.200000])children();}
module part_TP13(part=true,hole=false,block=false)
{
};
module C12(){translate([24.100000,-11.500000,1.200000])children();}
module part_C12(part=true,hole=false,block=false)
{
translate([24.100000,-11.500000,1.200000])m0(part,hole,block,casetop); // RevK:C_0201 C_0201_0603Metric (back)
};
module TP17(){translate([19.100000,-19.500000,1.200000])children();}
module part_TP17(part=true,hole=false,block=false)
{
};
module TP12(){translate([-21.000000,-19.500000,1.200000])children();}
module part_TP12(part=true,hole=false,block=false)
{
};
module D9(){translate([-17.500000,-5.900000,1.200000])rotate([0,0,-90.000000])children();}
module part_D9(part=true,hole=false,block=false)
{
translate([-17.500000,-5.900000,1.200000])rotate([0,0,-90.000000])m3(part,hole,block,casetop); // D7
};
module TP26(){translate([-13.000000,-19.500000,1.200000])children();}
module part_TP26(part=true,hole=false,block=false)
{
};
module TP1(){translate([-14.500000,-4.500000,1.200000])children();}
module part_TP1(part=true,hole=false,block=false)
{
};
module J2(){translate([-11.250000,-12.000000,1.200000])children();}
module part_J2(part=true,hole=false,block=false)
{
translate([-11.250000,-12.000000,1.200000])m17(part,hole,block,casetop,452); // J3
};
module V4(){translate([29.000000,-7.500000,1.200000])rotate([0,0,-90.000000])children();}
module part_V4(part=true,hole=false,block=false)
{
};
module D14(){translate([23.800000,-14.600000,1.200000])rotate([0,0,90.000000])children();}
module part_D14(part=true,hole=false,block=false)
{
translate([23.800000,-14.600000,1.200000])rotate([0,0,90.000000])m3(part,hole,block,casetop); // D7
};
module R13(){translate([10.000000,-0.500000,1.200000])children();}
module part_R13(part=true,hole=false,block=false)
{
translate([10.000000,-0.500000,1.200000])m1(part,hole,block,casetop); // RevK:R_0201 R_0201_0603Metric (back)
};
module V1(){translate([0.000000,17.500000,1.200000])children();}
module part_V1(part=true,hole=false,block=false)
{
};
module U5(){translate([21.600000,-14.100000,1.200000])children();}
module part_U5(part=true,hole=false,block=false)
{
translate([21.600000,-14.100000,1.200000])m20(part,hole,block,casetop); // U5
};
module D13(){translate([23.800000,-12.800000,1.200000])rotate([0,0,-90.000000])children();}
module part_D13(part=true,hole=false,block=false)
{
translate([23.800000,-12.800000,1.200000])rotate([0,0,-90.000000])m3(part,hole,block,casetop); // D7
};
module C22(){translate([4.400000,12.300000,1.200000])rotate([0,0,90.000000])children();}
module part_C22(part=true,hole=false,block=false)
{
translate([4.400000,12.300000,1.200000])rotate([0,0,90.000000])m0(part,hole,block,casetop); // RevK:C_0201 C_0201_0603Metric (back)
};
module C25(){translate([1.400000,12.300000,1.200000])rotate([0,0,90.000000])children();}
module part_C25(part=true,hole=false,block=false)
{
translate([1.400000,12.300000,1.200000])rotate([0,0,90.000000])m0(part,hole,block,casetop); // RevK:C_0201 C_0201_0603Metric (back)
};
module V2(){translate([0.000000,-30.500000,1.200000])rotate([0,0,180.000000])children();}
module part_V2(part=true,hole=false,block=false)
{
};
module C21(){translate([1.350000,9.700000,1.200000])rotate([0,0,180.000000])children();}
module part_C21(part=true,hole=false,block=false)
{
translate([1.350000,9.700000,1.200000])rotate([0,0,180.000000])m21(part,hole,block,casetop); // RevK:C_0402 C_0402_1005Metric (back)
};
module U7(){translate([16.000000,16.000000,1.200000])rotate([0,0,-90.000000])children();}
module part_U7(part=true,hole=false,block=false)
{
translate([16.000000,16.000000,1.200000])rotate([0,0,-90.000000])m22(part,hole,block,casetop); // U7
};
module D4(){translate([5.675000,15.800000,1.200000])rotate([0,0,90.000000])children();}
module part_D4(part=true,hole=false,block=false)
{
translate([5.675000,15.800000,1.200000])rotate([0,0,90.000000])m11(part,hole,block,casetop); // D5
};
module U1(){translate([-10.000000,4.500000,1.200000])children();}
module part_U1(part=true,hole=false,block=false)
{
translate([-10.000000,4.500000,1.200000])m23(part,hole,block,casetop); // U1
};
module TP2(){translate([-15.500000,-4.500000,1.200000])children();}
module part_TP2(part=true,hole=false,block=false)
{
};
module TP22(){translate([-9.500000,-4.500000,1.200000])children();}
module part_TP22(part=true,hole=false,block=false)
{
};
module TP14(){translate([20.100000,-15.900000,1.200000])children();}
module part_TP14(part=true,hole=false,block=false)
{
};
module D19(){translate([-6.700000,-5.100000,1.200000])rotate([0,0,180.000000])children();}
module part_D19(part=true,hole=false,block=false)
{
translate([-6.700000,-5.100000,1.200000])rotate([0,0,180.000000])m12(part,hole,block,casetop); // RevK:D_SOD-123FL D_SOD-123 (back)
};
module TP6(){translate([-13.500000,-4.500000,1.200000])children();}
module part_TP6(part=true,hole=false,block=false)
{
};
module PCB1(){translate([0.000000,-7.500000,1.200000])children();}
module part_PCB1(part=true,hole=false,block=false)
{
};
module TP3(){translate([-16.500000,-4.500000,1.200000])children();}
module part_TP3(part=true,hole=false,block=false)
{
};
module V3(){translate([-29.000000,-7.500000,1.200000])rotate([0,0,90.000000])children();}
module part_V3(part=true,hole=false,block=false)
{
};
module R12(){translate([3.200000,12.300000,1.200000])rotate([0,0,90.000000])children();}
module part_R12(part=true,hole=false,block=false)
{
translate([3.200000,12.300000,1.200000])rotate([0,0,90.000000])m1(part,hole,block,casetop); // RevK:R_0201 R_0201_0603Metric (back)
};
module R4(){translate([1.750000,-8.300000,1.200000])rotate([0,0,90.000000])children();}
module part_R4(part=true,hole=false,block=false)
{
translate([1.750000,-8.300000,1.200000])rotate([0,0,90.000000])m1(part,hole,block,casetop); // RevK:R_0201 R_0201_0603Metric (back)
};
module C6(){translate([16.000000,14.400000,1.200000])rotate([0,0,180.000000])children();}
module part_C6(part=true,hole=false,block=false)
{
translate([16.000000,14.400000,1.200000])rotate([0,0,180.000000])m0(part,hole,block,casetop); // RevK:C_0201 C_0201_0603Metric (back)
};
module C7(){translate([-23.400000,8.400000,1.200000])rotate([0,0,-90.000000])children();}
module part_C7(part=true,hole=false,block=false)
{
translate([-23.400000,8.400000,1.200000])rotate([0,0,-90.000000])m0(part,hole,block,casetop); // RevK:C_0201 C_0201_0603Metric (back)
};
module C24(){translate([2.100000,2.000000,1.200000])children();}
module part_C24(part=true,hole=false,block=false)
{
translate([2.100000,2.000000,1.200000])m13(part,hole,block,casetop); // RevK:C_0805 C_0805_2012Metric (back)
};
module U6(){translate([-12.000000,-25.000000,1.200000])rotate([0,0,-90.000000])children();}
module part_U6(part=true,hole=false,block=false)
{
translate([-12.000000,-25.000000,1.200000])rotate([0,0,-90.000000])m24(part,hole,block,casetop); // RevK:IR-SMD-4P,3.35x3.9mm IR-3.35x3.9 (back)
};
module R6(){translate([-18.500000,7.400000,1.200000])rotate([0,0,-90.000000])children();}
module part_R6(part=true,hole=false,block=false)
{
translate([-18.500000,7.400000,1.200000])rotate([0,0,-90.000000])m1(part,hole,block,casetop); // RevK:R_0201 R_0201_0603Metric (back)
};
module TP4(){translate([-17.500000,-4.500000,1.200000])children();}
module part_TP4(part=true,hole=false,block=false)
{
};
module T1(){translate([26.700000,-11.500000,1.200000])rotate([0,0,90.000000])children();}
module part_T1(part=true,hole=false,block=false)
{
translate([26.700000,-11.500000,1.200000])rotate([0,0,90.000000])m25(part,hole,block,casetop); // T1
};
// Parts to go on PCB (top)
module parts_top(part=false,hole=false,block=false){
part_C8(part,hole,block);
part_R3(part,hole,block);
part_R11(part,hole,block);
part_SW1(part,hole,block);
part_D7(part,hole,block);
part_U8(part,hole,block);
part_TP24(part,hole,block);
part_C3(part,hole,block);
part_D3(part,hole,block);
part_TP18(part,hole,block);
part_R9(part,hole,block);
part_C9(part,hole,block);
part_TP21(part,hole,block);
part_TP10(part,hole,block);
part_D8(part,hole,block);
part_TP20(part,hole,block);
part_D10(part,hole,block);
part_C1(part,hole,block);
part_TP25(part,hole,block);
part_TP9(part,hole,block);
part_TP8(part,hole,block);
part_L2(part,hole,block);
part_R5(part,hole,block);
part_R7(part,hole,block);
part_TP16(part,hole,block);
part_TP23(part,hole,block);
part_TP19(part,hole,block);
part_C10(part,hole,block);
part_TP15(part,hole,block);
part_C11(part,hole,block);
part_J1(part,hole,block);
part_D5(part,hole,block);
part_C23(part,hole,block);
part_D20(part,hole,block);
part_D6(part,hole,block);
part_D11(part,hole,block);
part_TP7(part,hole,block);
part_C5(part,hole,block);
part_TP11(part,hole,block);
part_C20(part,hole,block);
part_TP5(part,hole,block);
part_R10(part,hole,block);
part_U2(part,hole,block);
part_U9(part,hole,block);
part_C13(part,hole,block);
part_D12(part,hole,block);
part_J3(part,hole,block);
part_J6(part,hole,block);
part_C4(part,hole,block);
part_TP13(part,hole,block);
part_C12(part,hole,block);
part_TP17(part,hole,block);
part_TP12(part,hole,block);
part_D9(part,hole,block);
part_TP26(part,hole,block);
part_TP1(part,hole,block);
part_J2(part,hole,block);
part_V4(part,hole,block);
part_D14(part,hole,block);
part_R13(part,hole,block);
part_V1(part,hole,block);
part_U5(part,hole,block);
part_D13(part,hole,block);
part_C22(part,hole,block);
part_C25(part,hole,block);
part_V2(part,hole,block);
part_C21(part,hole,block);
part_U7(part,hole,block);
part_D4(part,hole,block);
part_U1(part,hole,block);
part_TP2(part,hole,block);
part_TP22(part,hole,block);
part_TP14(part,hole,block);
part_D19(part,hole,block);
part_TP6(part,hole,block);
part_PCB1(part,hole,block);
part_TP3(part,hole,block);
part_V3(part,hole,block);
part_R12(part,hole,block);
part_R4(part,hole,block);
part_C6(part,hole,block);
part_C7(part,hole,block);
part_C24(part,hole,block);
part_U6(part,hole,block);
part_R6(part,hole,block);
part_TP4(part,hole,block);
part_T1(part,hole,block);
}

parts_top=56;
module J7(){translate([2.000000,-6.000000,0.000000])rotate([180,0,0])children();}
module part_J7(part=true,hole=false,block=false)
{
};
module J5(){translate([-10.000000,4.500000,0.000000])rotate([0,0,180.000000])rotate([180,0,0])children();}
module part_J5(part=true,hole=false,block=false)
{
};
// Parts to go on PCB (bottom)
module parts_bottom(part=false,hole=false,block=false){
part_J7(part,hole,block);
part_J5(part,hole,block);
}

parts_bottom=0;
module b(cx,cy,z,w,l,h){translate([cx-w/2,cy-l/2,z])cube([w,l,h]);}
module m0(part=false,hole=false,block=false,height)
{ // RevK:C_0201 C_0201_0603Metric
// 0402 Capacitor
if(part)
{
        b(0,0,0,1.1,0.4,0.2); // Pad size
        b(0,0,0,0.6,0.3,0.3); // Chip
}
}

module m1(part=false,hole=false,block=false,height)
{ // RevK:R_0201 R_0201_0603Metric
// 0402 Resistor
if(part)
{
	b(0,0,0,1.1,0.4,0.2); // Pad size
	b(0,0,0,0.6,0.3,0.3); // Chip
}
}

module m2(part=false,hole=false,block=false,height)
{ // SW1
if(part)
{
	intersection()
	{
    		translate([0,0,0.95])cube([7.4,7.5,1.9],center=true);
    		translate([0,0,0.99])rotate([0,0,45])cube([8.5,8.5,2],center=true);
	}
}
if(hole)
{
	translate([0,0,1])rotate([0,0,45])
	{
		rotate([15,0,0])cylinder(d=7,h=height,$fn=8);
		rotate([-15,0,0])cylinder(d=7,h=height,$fn=8);
		rotate([0,15,0])cylinder(d=7,h=height,$fn=8);
		rotate([0,-15,0])cylinder(d=7,h=height,$fn=8);
	}
}
if(block)
{
	hull()
	{
		translate([0,0,2.1])cylinder(d=10,h=1,$fn=8);
		translate([0,0,height])cylinder(d=15,h=1,$fn=8);
	}
}
}

module m3(part=false,hole=false,block=false,height)
{ // D7
// DFN1006-2L
if(part)
{
	b(0,0,0,1.0,0.6,0.45); // Chip
}
}

module m4(part=false,hole=false,block=false,height)
{ // U8
if(part)
{
	b(0,0,0,2,1.25,1);
}
if(hole)
{
	hull()
	{
		
		b(0,0,0,2,1.25,1);
        	rotate([-60,0,0]) translate([0,0,5]) b(0,0,0,5,5,1);
	}
}
if(block)
{
	 b(0,0,0,4,3.25,height);
}
}

module m5(part=false,hole=false,block=false,height)
{ // RevK:R_0402 R_0402_1005Metric
// 0402 Resistor
if(part)
{
	b(0,0,0,1.5,0.65,0.2); // Pad size
	b(0,0,0,1.0,0.5,0.5); // Chip
}
}

module m6(part=false,hole=false,block=false,height)
{ // L2
// 5x5x4 Inductor
if(part)
{
	b(0,0,0,5,5,4.3);
}
}

module m7(part=false,hole=false,block=false,height,N=0)
{ // RevK:LCD2 PinSocket_1x08_P2.54mm_Vertical
translate([0,-(N-1)*2.54/2,0])
{
if(part)
{
	b(0,0,0,2.54,N*2.54,4);
}
if(hole)
{
	b(0,0,3,2.54+0.2,N*2.54+0.4,height);
	for(x=[0:1:N-1])translate([0,(x-(N-1)/2)*2.54,-3.5])cylinder(r1=0.5,r2=1,h=2.5);
}
}
}

module m8(part=false,hole=false,block=false,height)
{ // RevK:LCD2 WSLCD2
// 2" LCD
if(part)
translate([-29,17.5,8.25]) rotate([180,0,0])
{
	// Main PCB
	hull()for(x=[2.5,55.5])for(y=[2.5,32.5])translate([x,y,6])cylinder(r=2.5,h=1.5,$fn=24);
	// Display
	translate([5,0,6])cube([48,35,4]);
	// Ribbon
	translate([3.5,7.5,6])cube([2,20,3.5]);
	translate([3.5,4,6])cube([2,2,3.5]);
}
if(hole)
translate([-29,17.5,8.25]) rotate([180,0,0])
{
        translate([29+1.5,17.5,10])hull(){cube([42,32,1],center=true);translate([0,0,7])cube([44,34,10],center=true);}
        hull()for(x=[2.5,55.5])for(y=[2.5,32.5])translate([x,y,0])cylinder(r=2.5,h=6,$fn=24);
        // Pins
        for(x=[0:1:7])translate([2.4,8.61+x*2.54,0])
        {
        	translate([0,0,7.5])cylinder(d1=1.5,d2=0.4,h=1.5,$fn=24);
        	translate([0,0,-2.5])cylinder(d2=1.5,d1=0.4,h=2.5-pcbthickness,$fn=24);
        }
        // Screws / Pillars
        for(x=[2.5,55.5])for(y=[2.5,32.5])translate([x,y,0])
        {
        	translate([0,0,-2.5])cylinder(d=4,h=1.5,$fn=24);
        	translate([0,0,-2])cylinder(d=2,h=3,$fn=24);
        	translate([0,0,7.5])cylinder(d=4,h=1.5,$fn=24);
        }
}
}

module m9(part=false,hole=false,block=false,height)
{ // RevK:LCD2 M2x6Pillar
if(part)
{
	translate([0,0,-2.5])cylinder(d=3.5,h=2.5,$fn=24);
}
if(hole)
{
	cylinder(d=3.5,h=8.5,$fn=24);
}
}

module m10(part=false,hole=false,block=false,height)
{ // RevK:LCD2 LCDHeader
if(hole)
{
	b(0,0,0,6,20,height+1);
	b(-21,0,0,20,20,height+1);
}
}

module m11(part=false,hole=false,block=false,height)
{ // D5
// 1.6x1.5mm LED
if(part)
{

        b(0,0,0,1.5,1.6,0.28);
        b(0,0,0,1.5,1,0.6);
}
if(hole)
{
        hull()
        {
                b(0,0,.8,1.2,1.2,1);
                rotate([-60,0,-90]) translate([0,0,5]) b(0,0,0,5,5,1);
        }
}
if(block)
{
        b(0,0,0,3.5,3.6,height);
}
}

module m12(part=false,hole=false,block=false,height)
{ // RevK:D_SOD-123FL D_SOD-123
// SOD-123 Diode
if(part)
{
	b(0,0,0,2.85,1.8,1.35); // part
	b(0,0,0,4.2,1.2,0.7); // pads
}
}

module m13(part=false,hole=false,block=false,height)
{ // RevK:C_0805 C_0805_2012Metric
// 0805 Capacitor
if(part)
{
	b(0,0,0,2,1.2,1); // Chip
	b(0,0,0,2,1.45,0.2); // Pad size
}
}

module m14(part=false,hole=false,block=false,height)
{ // U2
if(part)
{
	b(0,0,0,10.4,10.4,1);	// Base board
	hull()
	{
		for(x=[-3.3,3.3])for(y=[-3.3,3.3])translate([x,y,0])cylinder(r=1,h=1,$fn=8);
		for(x=[-3,3])for(y=[-3,3])translate([x,y,4.8])sphere(r=1,$fn=12);
	}
}
if(hole)
{
		for(x=[-2,2])for(y=[-2,2])translate([x,y,1])cylinder(d=2,h=height,$fn=8);
}
if(block)
{
	b(0,0,0,12,12,height+1);
}
}

module m15(part=false,hole=false,block=false,height)
{ // RevK:SOT-5x3-6 SOT-563
// SOT-563
if(part)
{
	b(0,0,0,1.3,1.7,1); // Part
	b(0,0,0,1.35,2.1,0.2); // Pads
}
}

module m16(part=false,hole=false,block=false,height)
{ // RevK:C_0603 C_0603_1608Metric
// 0603 Capacitor
if(part)
{
	b(0,0,0,1.6,0.8,1); // Chip
	b(0,0,0,1.6,0.95,0.2); // Pad size
}
}

module m17(part=false,hole=false,block=false,height,N=0)
{ // J3
// WAGO-2060-45x-998-404
n=N%10; // 45x
if(part)
{
	translate([-0.9,0,0])hull()
	{
		b(0,0,0,12.7,n*4-0.1,1);
		translate([0.8,0,0])b(0,0,0,11.1,n*4-0.1,4.5);
	}
	for(p=[0:n-1])hull()
    {
        translate([-6,-4*(n-1)/2+p*4,2])sphere(d=3,$fn=12);
        translate([-11.510,0,2])sphere(d=4,$fn=12);
    }
}
if(hole)
{
    hull()
    {
        translate([-11.510,0,2])sphere(d=4,$fn=12);
        translate([-11.510,0,-height])sphere(d=4,$fn=12);
    }
    hull()
    {
        translate([-11.510,0,2])sphere(d=4,$fn=12);
        translate([-50,0,2])sphere(d=4,$fn=12);
    }
}
}

module m18(part=false,hole=false,block=false,height)
{ // RevK:USB-C-Socket-H CSP-USC16-TR
// USB connector
rotate([-90,0,0])translate([0,1.9,0])
{
	if(part)
	{
        b(0,1.57,0,7,1.14,0.2); // Pads

		translate([0,1.76-7.55,1.63])
		rotate([-90,0,0])
		hull()
		{
			translate([(8.94-3.26)/2,0,0])
			cylinder(d=3.26,h=7.55,$fn=24);
			translate([-(8.94-3.26)/2,0,0])
			cylinder(d=3.26,h=7.55,$fn=24);
		}
		translate([-8.94/2,0.99-1.1/2,0])cube([8.94,1.1,1.6301]);
		translate([-8.94/2,-3.2-1.6/2,0])cube([8.94,1.6,1.6301]);
	}
	if(hole)
		translate([0,-5.79,1.63])
		rotate([-90,0,0])
	{
		// Plug
		hull()
		{
			translate([(8.34-2.5)/2,0,-23+1])
			cylinder(d=2.5,h=23,$fn=24);
			translate([-(8.34-2.5)/2,0,-23+1])
			cylinder(d=2.5,h=23,$fn=24);
		}
		hull()
		{
            translate([(12-7)/2,0,-21-1])
			cylinder(d=7,h=21,$fn=24);
            translate([-(12-7)/2,0,-21-1])
			cylinder(d=7,h=21,$fn=24);
		}
		translate([0,0,-100-10])
			cylinder(d=5,h=100,$fn=24);
	}
}
}

module m19(part=false,hole=false,block=false,height)
{ // C4
if(part)
{
	b(0,0,0,3.5,2.8,1.9);
}
}

module m20(part=false,hole=false,block=false,height)
{ // U5
if(part)
{
	b(0,0,0,2.5,2,0.65);
}
}

module m21(part=false,hole=false,block=false,height)
{ // RevK:C_0402 C_0402_1005Metric
// 0402 Capacitor
if(part)
{
	b(0,0,0,1.0,0.5,1); // Chip
	b(0,0,0,1.5,0.65,0.2); // Pad size
}
}

module m22(part=false,hole=false,block=false,height)
{ // U7
if(part)
{
	b(0,0,0,1.5,1.5,0.5);
}
if(hole)
{
	hull()
	{
                b(0,0,-2,6,6,4);
        	rotate([-60,0,90]) translate([0,0,8]) b(0,0,0,8,5,1);
	}
}
if(block)
{
    translate([0,0,height-6])b(0,0,-2,7,8,6);
}
}

module m23(part=false,hole=false,block=false,height)
{ // U1
// ESP32-S3-MINI-1
translate([-15.4/2,-15.45/2,0])
{
	if(part)
	{
		cube([15.4,20.5,0.8]);
		translate([0.7,0.5,0])cube([14,13.55,2.4]);
		cube([15.4,20.5,0.8]);
	}
}
}

module m24(part=false,hole=false,block=false,height)
{ // RevK:IR-SMD-4P,3.35x3.9mm IR-3.35x3.9
if(part)
{
	b(0,0,0,3.35,3.9,1.6);
	translate([0,0.45,1.6])sphere(r=1.4,$fn=24);
}
if(hole)
{
	hull()
	{
		translate([0,0.45,1.6])cylinder(d=2.4,$fn=24);
		translate([0,0.45,height])cylinder(d=6,h=height+1,$fn=6);
	}
}
if(block)
{
	hull()
	{
		translate([0,0.45,1.8])cylinder(d=4.4,$fn=24);
		translate([0,0.45,height])cylinder(d=8,h=height+1,$fn=6);
	}
}
}

module m25(part=false,hole=false,block=false,height)
{ // T1
if(part)
{
	b(0,0,0,2.65,3.5,0.98);
}
if(hole)
{
	translate([0,-0.71,-pcbthickness-0.01])
	hull()
	{
		cylinder(d=1,h=pcbthickness+0.02);
		translate([0,-10+casewall+1,0])cylinder(d=1,h=pcbthickness+0.02);
	}
}
}

// Generate PCB casework

height=casebottom+pcbthickness+casetop;
$fn=48;

module pyramid()
{ // A pyramid
 polyhedron(points=[[0,0,0],[-height,-height,height],[-height,height,height],[height,height,height],[height,-height,height]],faces=[[0,1,2],[0,2,3],[0,3,4],[0,4,1],[4,3,2,1]]);
}


module pcb_hulled(h=pcbthickness,r=0)
{ // PCB shape for case
	if(useredge)outline(h,r);
	else hull()outline(h,r);
}

module solid_case(d=0)
{ // The case wall
	hull()
        {
                translate([0,0,-casebottom])pcb_hulled(height,casewall-edge);
                translate([0,0,edge-casebottom])pcb_hulled(height-edge*2,casewall);
        }
}

module preview()
{
	pcb();
	color("#0f0")parts_top(part=true);
	color("#0f0")parts_bottom(part=true);
	color("#f00")parts_top(hole=true);
	color("#f00")parts_bottom(hole=true);
	color("#00f8")parts_top(block=true);
	color("#00f8")parts_bottom(block=true);
}

module top_half(fit=0)
{
	difference()
	{
		translate([-casebottom-100,-casewall-100,pcbthickness+0.01]) cube([pcbwidth+casewall*2+200,pcblength+casewall*2+200,height]);
		translate([0,0,pcbthickness])
        	{
			snape=lip/5;
			snaph=(lip-snape*2)/3;
			if(lipt==1)rotate(lipa)hull()
			{
				translate([0,-pcblength,lip/2])cube([0.001,pcblength*2,0.001]);
				translate([-lip/2,-pcblength,0])cube([lip,pcblength*2,0.001]);
			} else if(lipt==2)for(a=[0,90,180,270])rotate(a+lipa)hull()
			{
				translate([0,-pcblength-pcbwidth,lip/2])cube([0.001,pcblength*2+pcbwidth*2,0.001]);
				translate([-lip/2,-pcblength-pcbwidth,0])cube([lip,pcblength*2+pcbwidth*2,0.001]);
			}
            		difference()
            		{
                		pcb_hulled(lip,casewall);
				if(snap)
                        	{
					hull()
					{
						pcb_hulled(0.1,casewall/2-snap/2+fit);
						translate([0,0,snape])pcb_hulled(snaph,casewall/2+snap/2+fit);
						translate([0,0,lip-snape-snaph])pcb_hulled(0.1,casewall/2-snap/2+fit);
					}
					translate([0,0,lip-snape-snaph])pcb_hulled(snaph,casewall/2-snap/2+fit);
					hull()
					{
						translate([0,0,lip-snape])pcb_hulled(0.1,casewall/2-snap/2+fit);
						translate([0,0,lip])pcb_hulled(0.1,casewall/2+snap/2+fit);
					}
                        	}
				else pcb_hulled(lip,casewall/2+fit);
				if(lipt==0)translate([-pcbwidth,-pcblength,0])cube([pcbwidth*2,pcblength*2,lip]);
				else if(lipt==1) rotate(lipa)translate([0,-pcblength,0])hull()
				{
					translate([lip/2,0,0])cube([pcbwidth,pcblength*2,lip]);
					translate([-lip/2,0,lip])cube([pcbwidth,pcblength*2,lip]);
				}
				else if(lipt==2)for(a=[0,180])rotate(a+lipa)hull()
                		{
                            		translate([lip/2,lip/2,0])cube([pcbwidth+pcblength,pcbwidth+pcblength,lip]);
                            		translate([-lip/2,-lip/2,lip])cube([pcbwidth+pcblength,pcbwidth+pcblength,lip]);
                		}
            		}
            		difference()
            		{
				if(snap)
                        	{
					hull()
					{
						translate([0,0,-0.1])pcb_hulled(0.1,casewall/2+snap/2-fit);
						translate([0,0,snape-0.1])pcb_hulled(0.1,casewall/2-snap/2-fit);
					}
					translate([0,0,snape])pcb_hulled(snaph,casewall/2-snap/2-fit);
					hull()
					{
						translate([0,0,snape+snaph])pcb_hulled(0.1,casewall/2-snap/2-fit);
						translate([0,0,lip-snape-snaph])pcb_hulled(snaph,casewall/2+snap/2-fit);
						translate([0,0,lip-0.1])pcb_hulled(0.1,casewall/2-snap/2-fit);
					}
                        	}
				else pcb_hulled(lip,casewall/2-fit);
				if(lipt==1)rotate(lipa+180)translate([0,-pcblength,0])hull()
				{
					translate([lip/2,0,0])cube([pcbwidth,pcblength*2,lip+0.1]);
					translate([-lip/2,0,lip])cube([pcbwidth,pcblength*2,lip+0.1]);
				}
				else if(lipt==2)for(a=[90,270])rotate(a+lipa)hull()
                		{
                            		translate([lip/2,lip/2,0])cube([pcbwidth+pcblength,pcbwidth+pcblength,lip]);
                            		translate([-lip/2,-lip/2,lip])cube([pcbwidth+pcblength,pcbwidth+pcblength,lip]);
                		}
			}
            	}
		minkowski()
                {
                	union()
                	{
                		parts_top(part=true,hole=true);
                		parts_bottom(part=true,hole=true);
                	}
                	translate([-0.01,-0.01,-height])cube([0.02,0.02,height]);
                }
        }
	minkowski()
        {
        	union()
                {
                	parts_top(part=true,hole=true);
                	parts_bottom(part=true,hole=true);
                }
                translate([-0.01,-0.01,0])cube([0.02,0.02,height]);
        }
}

module case_wall()
{
	difference()
	{
		solid_case();
		translate([0,0,-height])pcb_hulled(height*2,0.02);
	}
}

module top_side_hole()
{
	difference()
	{
		intersection()
		{
			parts_top(hole=true);
			case_wall();
		}
		translate([0,0,-casebottom])pcb_hulled(height,casewall);
	}
}

module bottom_side_hole()
{
	difference()
	{
		intersection()
		{
			parts_bottom(hole=true);
			case_wall();
		}
		translate([0,0,edge-casebottom])pcb_hulled(height-edge*2,casewall);
	}
}

module parts_space()
{
	minkowski()
	{
		union()
		{
			parts_top(part=true,hole=true);
			parts_bottom(part=true,hole=true);
		}
		sphere(r=margin,$fn=6);
	}
}

module top_cut(fit=0)
{
	difference()
	{
		top_half(fit);
		if(parts_top)difference()
		{
			minkowski()
			{ // Penetrating side holes
				top_side_hole();
				rotate([180,0,0])
				pyramid();
			}
			minkowski()
			{
				top_side_hole();
				rotate([0,0,45])cylinder(r=margin,h=height,$fn=4);
			}
		}
	}
	if(parts_bottom)difference()
	{
		minkowski()
		{ // Penetrating side holes
			bottom_side_hole();
			pyramid();
		}
			minkowski()
			{
				bottom_side_hole();
				rotate([0,0,45])translate([0,0,-height])cylinder(r=margin,h=height,$fn=4);
			}
	}
}

module bottom_cut()
{
	difference()
	{
		 translate([-casebottom-50,-casewall-50,-height]) cube([pcbwidth+casewall*2+100,pcblength+casewall*2+100,height*2]);
		 top_cut(-fit);
	}
}

module top_body()
{
	difference()
	{
		intersection()
		{
			solid_case();
			pcb_hulled(casetop+pcbthickness,0.03);
		}
		if(parts_top||topthickness)minkowski()
		{
			union()
			{
				if(nohull)parts_top(part=true);
				else hull(){parts_top(part=true);pcb_hulled();}
				if(topthickness)pcb_hulled(casetop+pcbthickness-topthickness,0);
			}
			translate([0,0,margin-height])cylinder(r=margin,h=height,$fn=8);
		}
	}
	intersection()
	{
		pcb_hulled(casetop+pcbthickness,0.03);
		union()
		{
			parts_top(block=true);
			parts_bottom(block=true);
		}
	}
}

module top_edge()
{
	intersection()
	{
		case_wall();
		top_cut();
	}
}

module top_pos()
{ // Position for plotting bottom
	translate([0,0,pcbthickness+casetop])rotate([180,0,0])children();
}

module pcb_pos()
{	// Position PCB relative to base 
		translate([0,0,pcbthickness-height])children();
}

module top()
{
	top_pos()difference()
	{
		union()
		{
			top_body();
			top_edge();
		}
		parts_space();
		pcb_pos()pcb(height,r=margin);
	}
}

module bottom_body()
{ // Position for plotting top
	difference()
	{
		intersection()
		{
			solid_case();
			translate([0,0,-casebottom])pcb_hulled(casebottom+pcbthickness,0.03);
		}
		if(parts_bottom||bottomthickness)minkowski()
		{
			union()
			{
				if(nohull)parts_bottom(part=true);
				else hull()parts_bottom(part=true);
				if(bottomthickness)translate([0,0,bottomthickness-casebottom])pcb_hulled(casebottom+pcbthickness-bottomthickness,0);
			}
			translate([0,0,-margin])cylinder(r=margin,h=height,$fn=8);
		}
	}
	intersection()
	{
		translate([0,0,-casebottom])pcb_hulled(casebottom+pcbthickness,0.03);
		union()
		{
			parts_top(block=true);
			parts_bottom(block=true);
		}
	}
}

module bottom_edge()
{
	intersection()
	{
		case_wall();
		bottom_cut();
	}
}

module bottom_pos()
{
	translate([0,0,casebottom])children();
}

module bottom()
{
	bottom_pos()difference()
	{
		union()
		{
        		bottom_body();
        		bottom_edge();
		}
		parts_space();
		pcb(height,r=margin);
	}
}

module datecode()
{
	minkowski()
	{
		translate([datex,datey,-1])rotate(datea)scale([-1,1])linear_extrude(1)text(date,size=dateh,halign="center",valign="center",font=datef);
		cylinder(d1=datet,d2=0,h=datet,$fn=6);
	}
}

module logocode()
{
	minkowski()
	{
		translate([logox,logoy,-1])rotate(logoa)scale([-1,1])linear_extrude(1)text(logo,size=logoh,halign="center",valign="center",font=logof);
		cylinder(d1=logot,d2=0,h=logot,$fn=6);
	}
}
translate([-56/2,-36/2,0])cube([56,36,1]);
translate([19,20.5,0])cube([9,9,1]);
translate([-15.5,20.5,0])cube([8,10,1]);
translate([-23.5,25,0])cylinder(d=13,h=1);
translate([0,0,0])top();
