revk/ESP32-Remote/(list of files, cad)

Other CAD files:
PCB/Remote/Remote----IB.stl
PCB/Remote/Remote---C-B.stl
PCB/Remote/Remote----I-.stl
PCB/Remote/Remote--D--B.stl
PCB/Remote/Remote-P-CI-.stl
PCB/Remote/Remote-P---B.stl
PCB/Remote/Remote---CIB.stl
PCB/Remote/Remote---CI-.stl
PCB/Remote/Remote-PD-I-.stl
PCB/Remote/Remote--D-IB.stl
PCB/Remote/Remote------.stl
PCB/Remote/Remote-PD-IB.stl
PCB/Remote/Remote--DC-B.stl
PCB/Remote/Remote--DCI-.stl
PCB/Remote/Remote-PDCI-.stl
PCB/Remote/Remote--D---.stl
PCB/Remote/Remote-P-CIB.stl
PCB/Remote/Remote-P-C--.stl
PCB/Remote/Remote-PD---.stl
PCB/Remote/Remote-P--IB.stl
PCB/Remote/Remote---C--.stl
PCB/Remote/Remote-P--I-.stl
PCB/Remote/Remote-P----.stl
PCB/Remote/Remote-PDCIB.stl
PCB/Remote/Remote-PDC--.stl
PCB/Remote/Remote-PD--B.stl
PCB/Remote/Remote-----B.scad
PCB/Remote/Remote----I-.scad
PCB/Remote/Remote----IB.scad
PCB/Remote/Remote---C--.scad
PCB/Remote/Remote---C-B.scad
PCB/Remote/Remote---CI-.scad
PCB/Remote/Remote---CIB.scad
PCB/Remote/Remote--D---.scad
PCB/Remote/Remote--D--B.scad
PCB/Remote/Remote--D-I-.scad
PCB/Remote/Remote--D-IB.scad
PCB/Remote/Remote--DC--.scad
PCB/Remote/Remote--DC-B.scad
PCB/Remote/Remote--DCI-.scad
PCB/Remote/Remote--DCIB.scad
PCB/Remote/Remote-Base.scad
PCB/Remote/Remote-P----.scad
PCB/Remote/Remote-P---B.scad
PCB/Remote/Remote-P--I-.scad
PCB/Remote/Remote-P--IB.scad
PCB/Remote/Remote-P-C--.scad
PCB/Remote/Remote-P-C-B.scad
PCB/Remote/Remote-P-CI-.scad
PCB/Remote/Remote-P-CIB.scad
PCB/Remote/Remote-PD---.scad
PCB/Remote/Remote-PD--B.scad
PCB/Remote/Remote-PD-I-.scad
PCB/Remote/Remote-PD-IB.scad
PCB/Remote/Remote-PDC--.scad
PCB/Remote/Remote-PDC-B.scad
PCB/Remote/Remote-PDCI-.scad
PCB/Remote/Remote-PDCIB.scad
PCB/Remote/Remote.scad
PCB/Remote/RemoteCO2.scad
PCB/Remote/RemoteNOCO2.scad
PCB/Remote/Remote.stl
PCB/Remote/blankplate.scad
