revk/ESP32-Remote/PCB/Remote/Remote.kicad_pcb

## KiCad design PCB/Remote/Remote.kicad_pcb (2026-01-03)

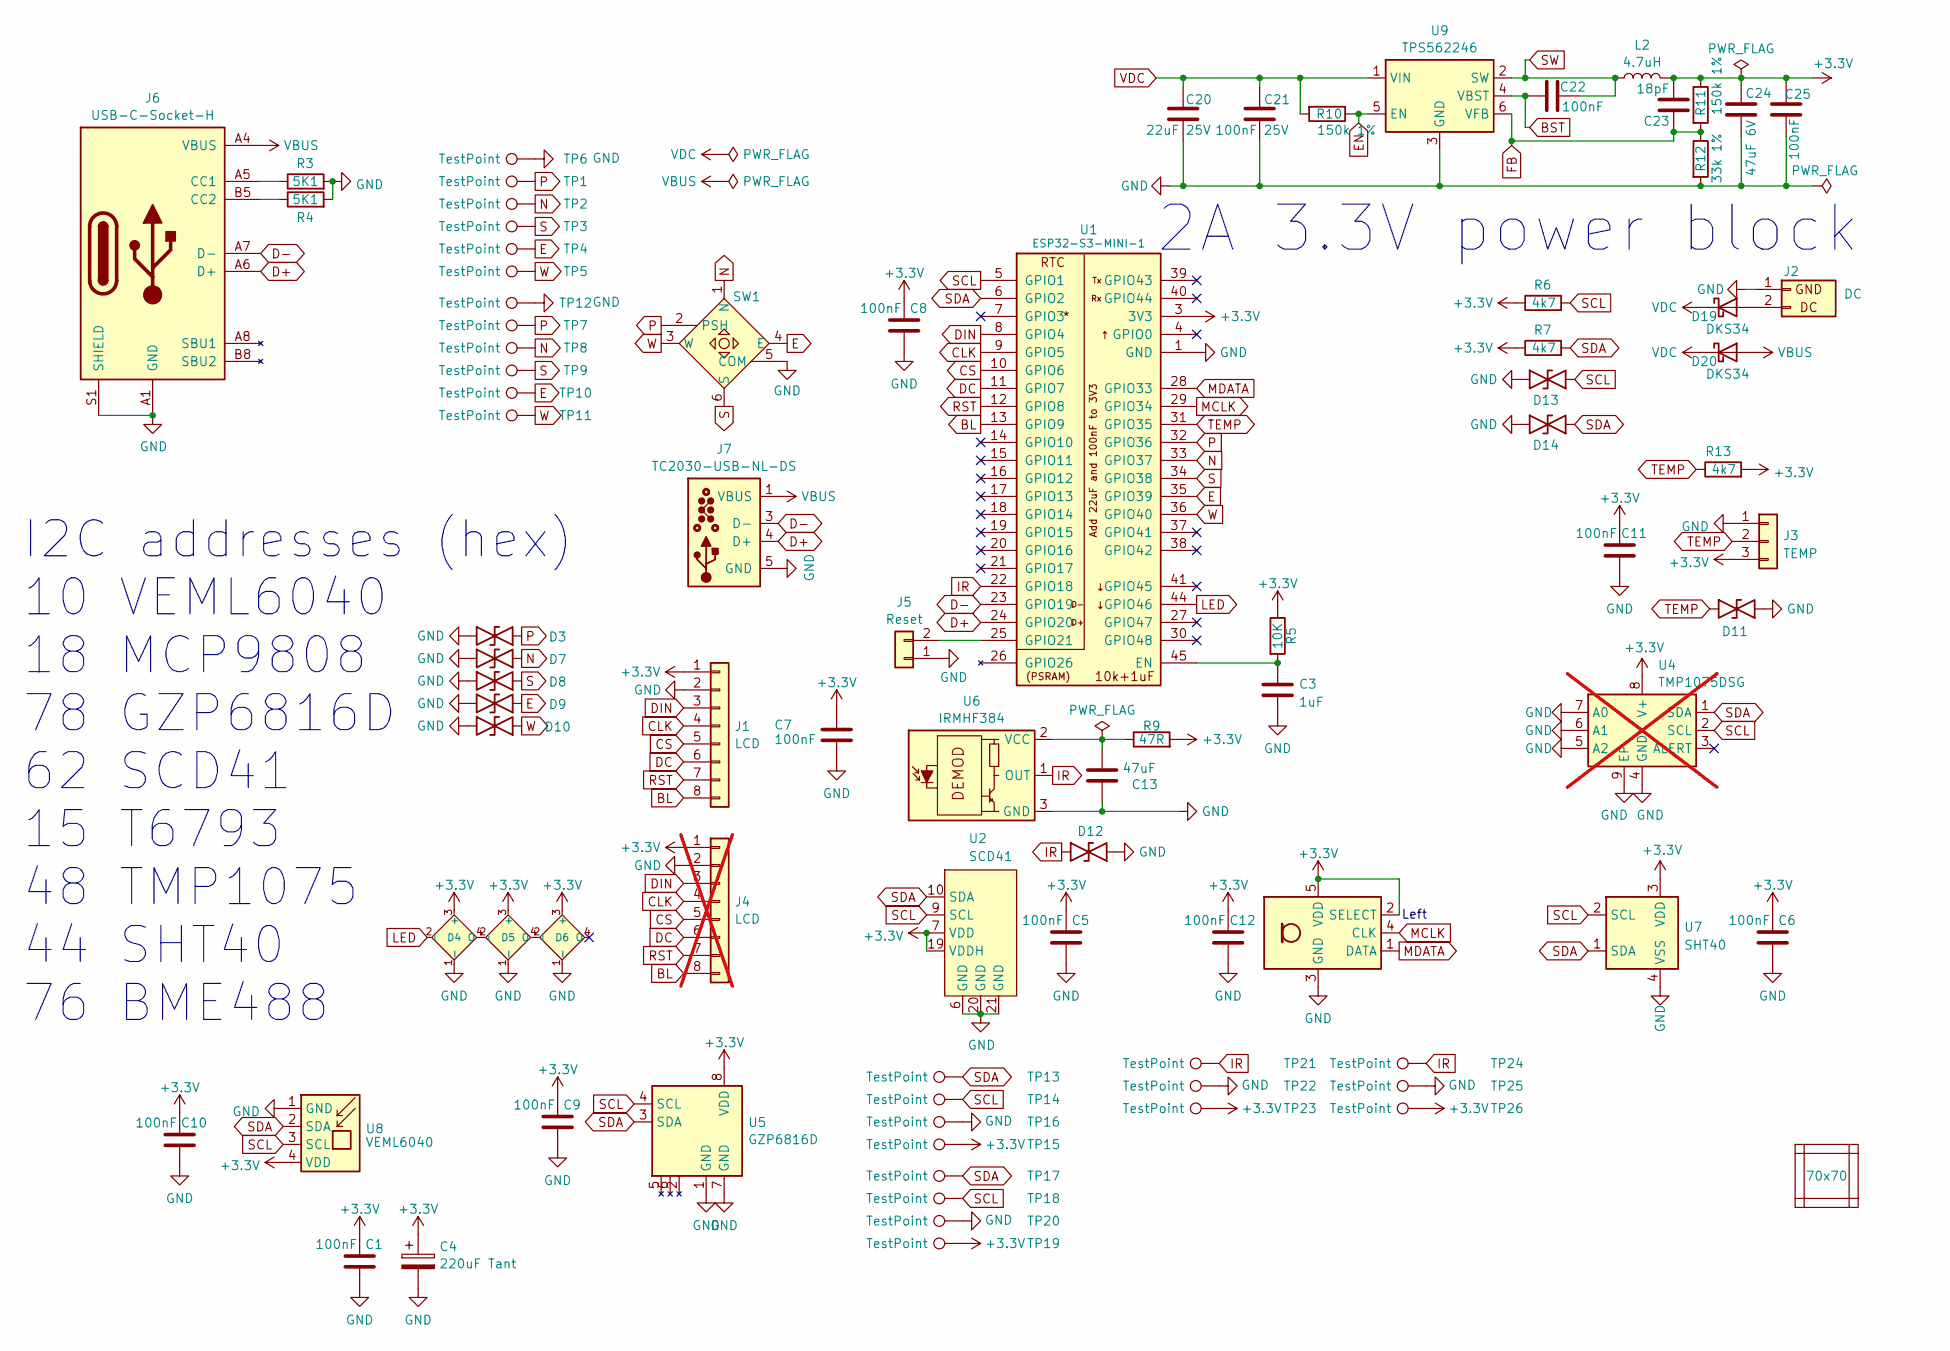
[picture p20: schematic Remote.kicad_sch]

Parts:
C1, C5, C6, C8, C9, C10, C11, C12, C22, C25: 100nF; C_0201; MPN C76934
C3: 1uF; C_0201
C4: 220uF Tant; CP_EIA-3528-21_Kemet-B; MPN C122649
C7: 100nF; C_0201
C13: 47uF; C_0603
C20: 22uF 25V; C_0805; MPN C45783
C21: 100nF 25V; C_0402; MPN C56392
C23: 18pF; C_0201; MPN C62164
C24: 47uF 6V; C_0805; MPN C16780
D3, D7, D8, D9, D10, D11, D12, D13, D14: DFN1006-2L; MPN C5137770
D4: XL-1615RGBC-2812B; SMD1615-Side; MPN C5349954
D5, D6: XL-1010RGBC-WS2812B; SMD1615-Side; MPN C5349954
D19, D20: DKS34; D_SOD-123FL; MPN C727076
J1: LCD; LCD2; MPN C42380985
J2: DC; WAGO-2060-452-998-404; MPN C2765055
J3: TEMP; WAGO-2060-453-998-404; MPN C2765056
J4: LCD; PinHeader_1x08_P2.54mm_Vertical; MPN C42380985; not fitted
J5: Reset; AA-Pad
J6: USB-C-Socket-H; MPN C709357
J7: TC2030-USB-NL-DS; Tag-Connect_TC2030-IDC-NL_2x03_P1.27mm_Vertical
L2: 4.7uH; L_5x5; MPN C307876
PCB1: 70x70; PCB7070
R3, R4: 5K1; R_0201; MPN C473460
R5: 10K; R_0201; MPN C102690
R6, R7, R13: 4k7; R_0201; MPN C7467262
R9: 47R; R_0402; MPN C854484
R10, R11: 150k 1%; R_0201; MPN C310173
R12: 33k 1%; R_0201; MPN C320835
SW1: Switch-Nav5; MPN C145900
T1: T3902_MEMS_Mic; T3902_MEMS_Mic_Open; MPN C3171752
TP1, TP2, TP3, TP4, TP5, TP7, TP8, TP9, TP10, TP11, TP13, TP14, TP15, TP17, TP18, TP19, TP21, TP23, TP24, TP26: TestPoint; TestPad
TP6, TP12, TP16, TP20, TP22, TP25: TestPoint; TestPadSquare
U1: ESP32-S3-MINI-1; MPN C3013941
U2: SCD41; MPN C3659294
U4: TMP1075DSG; WSON-8-1EP_2x2mm_P0.5mm_EP0.9x1.6mm_ThermalVias-Side; MPN C2870250; not fitted
U5: GZP6816D; Bosch_LGA-8_2x2.5mm_P0.65mm_ClockwisePinNumbering; MPN C3038127
U6: IRMHF384; IR-SMD-4P,3.35x3.9mm; MPN C7280961
U7: SHT40; Sensirion_DFN-4_1.5x1.5mm_P0.5mm_SHT4x-Side; MPN C2909890
U8: VEML6040; VEML6040-Side; MPN C78465
U9: TPS562246; SOT-5x3-6; MPN C41833479
V1, V2, V3, V4: VCUT70

Connections:
+3.3V: C1.2, C4.1, C5.2, C6.2, C7.1, C8.2, C9.2, C10.2, C11.2, C12.2, C23.2, C24.1, C25.2, D4.3 (+), D5.3 (+), D6.3 (+), J1.1, J3.3, J4.1, L2.2, R5.1, R6.1, R7.1, R9.2, R11.1, R13.2, T1.2 (SELECT), T1.5 (VDD), TP15.1, TP19.1, TP23.1, TP26.1, U1.3 (3V3), U2.7 (VDD), U2.19 (VDDH), U5.8 (VDD), U7.3 (VDD), U8.4 (VDD)
BL: J1.8, J4.8, U1.13 (GPIO9)
BST: C22.1, U9.4 (VBST)
CLK: J1.4, J4.4, U1.9 (GPIO5)
CS: J1.5, J4.5, U1.10 (GPIO6)
D+: J6.A6 (D+), J6.B6 (D+), J7.4 (D+), U1.24 (GPIO20)
D-: J6.A7 (D-), J6.B7 (D-), J7.2 (NC), J7.3 (D-), J7.6 (NC), U1.23 (GPIO19)
DC: J1.6, J4.6, U1.11 (GPIO7)
DIN: J1.3, J4.3, U1.8 (GPIO4)
E: D9.1, SW1.4 (E), TP4.1, TP10.1, U1.35 (GPIO39)
EN: R10.1, U9.5 (EN)
FB: C23.1, R11.2, R12.1, U9.6 (VFB)
GND: C1.1, C3.2, C4.2, C5.1, C6.1, C7.2, C8.1, C9.1, C10.1, C11.1, C12.1, C13.2, C20.2, C21.2, C24.2, C25.1, D3.2, D4.1 (-), D5.1 (-), D6.1 (-), D7.2, D8.2, D9.2, D10.2, D11.1, D12.1, D13.1, D14.1, J1.2, J2.1 (GND), J3.1, J4.2, J5.1, J6.A1 (GND), J6.A12 (GND), J6.B1 (GND), J6.B12 (GND), J6.S1 (SHIELD), J7.5 (GND), R3.2, R4.2, R12.2, SW1.5 (COM), T1.3 (GND), TP6.1, TP12.1, TP16.1, TP20.1, TP22.1, TP25.1, U1.1 (GND), U1.2 (GND), U1.42 (GND), U1.43 (GND), U1.46 (GND), U1.47 (GND), U1.48 (GND), U1.49 (GND), U1.50 (GND), U1.51 (GND), U1.52 (GND), U1.53 (GND), U1.54 (GND), U1.55 (GND), U1.56 (GND), U1.57 (GND), U1.58 (GND), U1.59 (GND), U1.60 (GND), U1.61 (GND), U1.62 (GND), U1.63 (GND), U1.64 (GND), U1.65 (GND), U2.6 (GND), U2.20 (GND), U2.21 (GND), U5.1 (GND), U5.7 (GND), U6.3 (GND), U6.4 (GND), U7.4 (VSS), U8.1 (GND), U9.3 (GND)
IR: D12.2, TP21.1, TP24.1, U1.22 (GPIO18), U6.1 (OUT)
LED: D4.2 (I), U1.44 (GPIO46)
MCLK: T1.4 (CLK), U1.29 (GPIO34)
MDATA: T1.1 (DATA), U1.28 (GPIO33)
N: D7.1, SW1.1 (N), TP2.1, TP8.1, U1.33 (GPIO37)
unnamed: D4.4 (O), D5.2 (I)
unnamed: D5.4 (O), D6.2 (I)
unnamed: D19.2 (A), J2.2 (DC)
unnamed: J5.2, U1.25 (GPIO21)
unnamed: J6.A5 (CC1), R3.1
unnamed: J6.B5 (CC2), R4.1
unnamed: C3.1, R5.2, U1.45 (EN)
unnamed: C13.1, R9.1, U6.2 (VCC)
P: D3.1, SW1.2 (PSH), TP1.1, TP7.1, U1.32 (GPIO36)
RST: J1.7, J4.7, U1.12 (GPIO8)
S: D8.1, SW1.6 (S), TP3.1, TP9.1, U1.34 (GPIO38)
SCL: D13.2, R6.2, TP14.1, TP18.1, U1.5 (GPIO1), U2.5 (DNC), U2.9 (SCL), U4.2 (SCL), U5.4 (SCL), U7.2 (SCL), U8.3 (SCL)
SDA: D14.2, R7.2, TP13.1, TP17.1, U1.6 (GPIO2), U2.10 (SDA), U5.3 (SDA), U7.1 (SDA), U8.2 (SDA)
SW: C22.2, L2.1, U9.2 (SW)
TEMP: D11.2, J3.2, R13.1, U1.31 (GPIO35)
VBUS: D20.2 (A), J6.A4 (VBUS), J6.A9 (VBUS), J6.B4 (VBUS), J6.B9 (VBUS), J7.1 (VBUS)
VDC: C20.1, C21.1, D19.1 (K), D20.1 (K), R10.2, U9.1 (VIN)
W: D10.1, SW1.3 (W), TP5.1, TP11.1, U1.36 (GPIO40)

Notes on the sheet:
2A 3.3V power block
I2C addresses (hex) 10 VEML6040 18 MCP9808 78 GZP6816D 62 SCD41 15 T6793 48 TMP1075 44 SHT40 76 BME488
Left

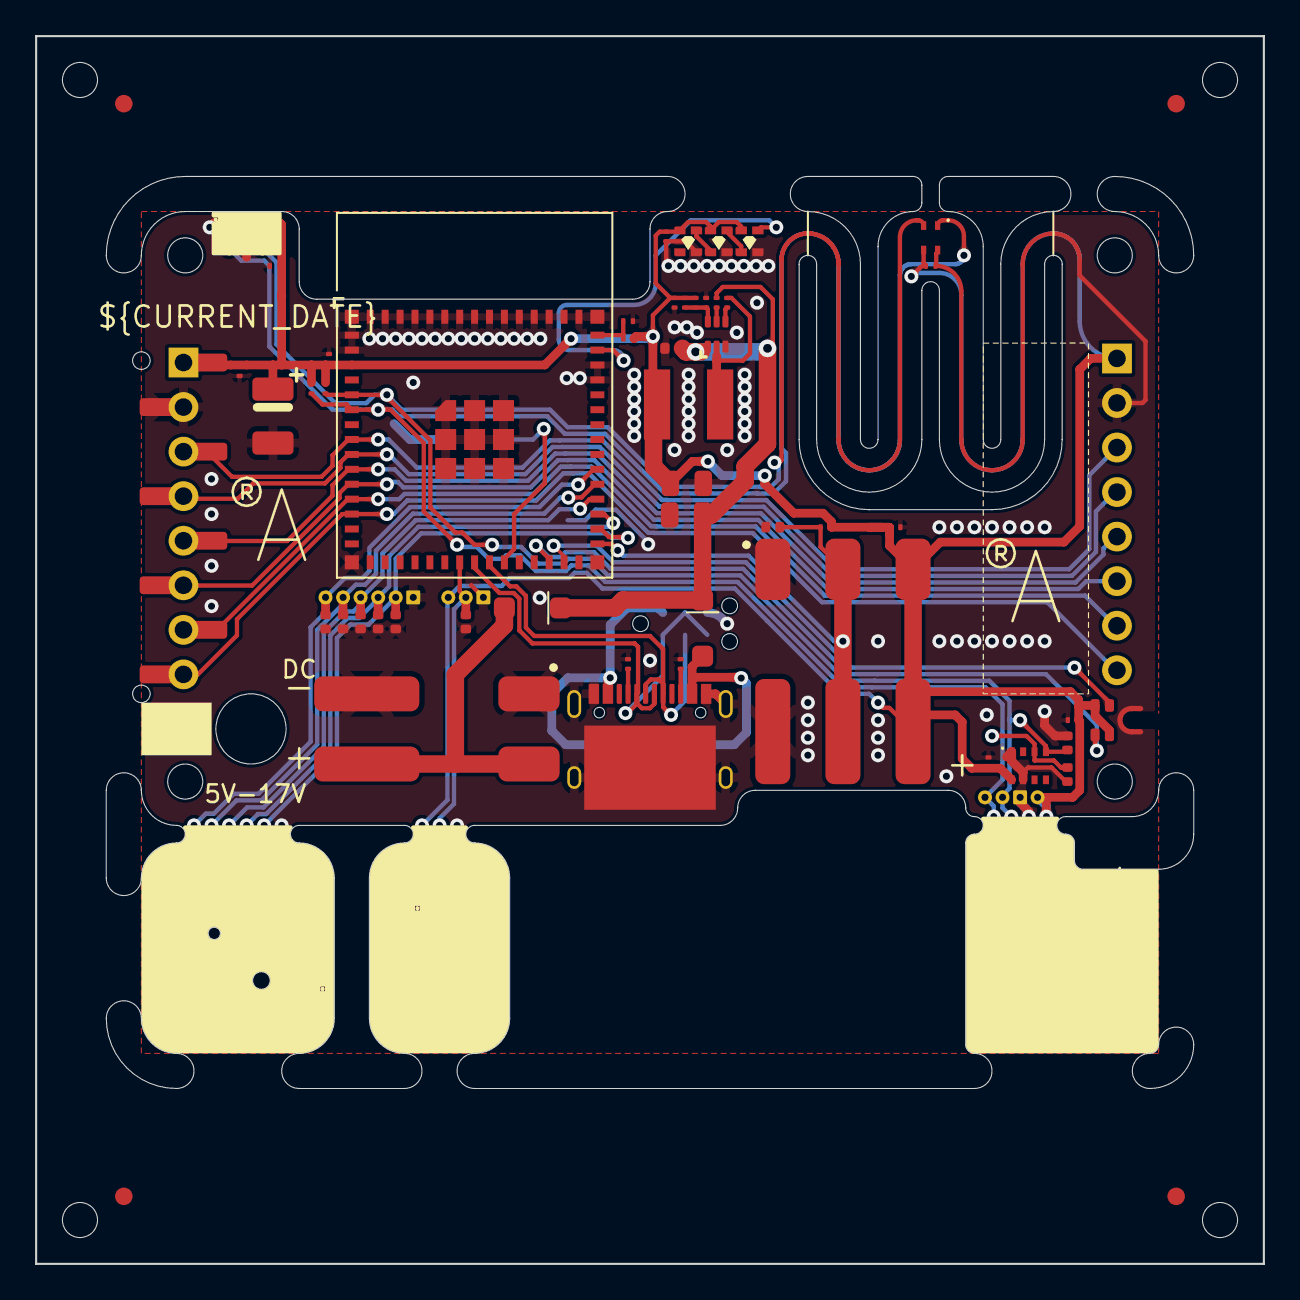
[picture p21: board Remote.kicad_pcb from above]

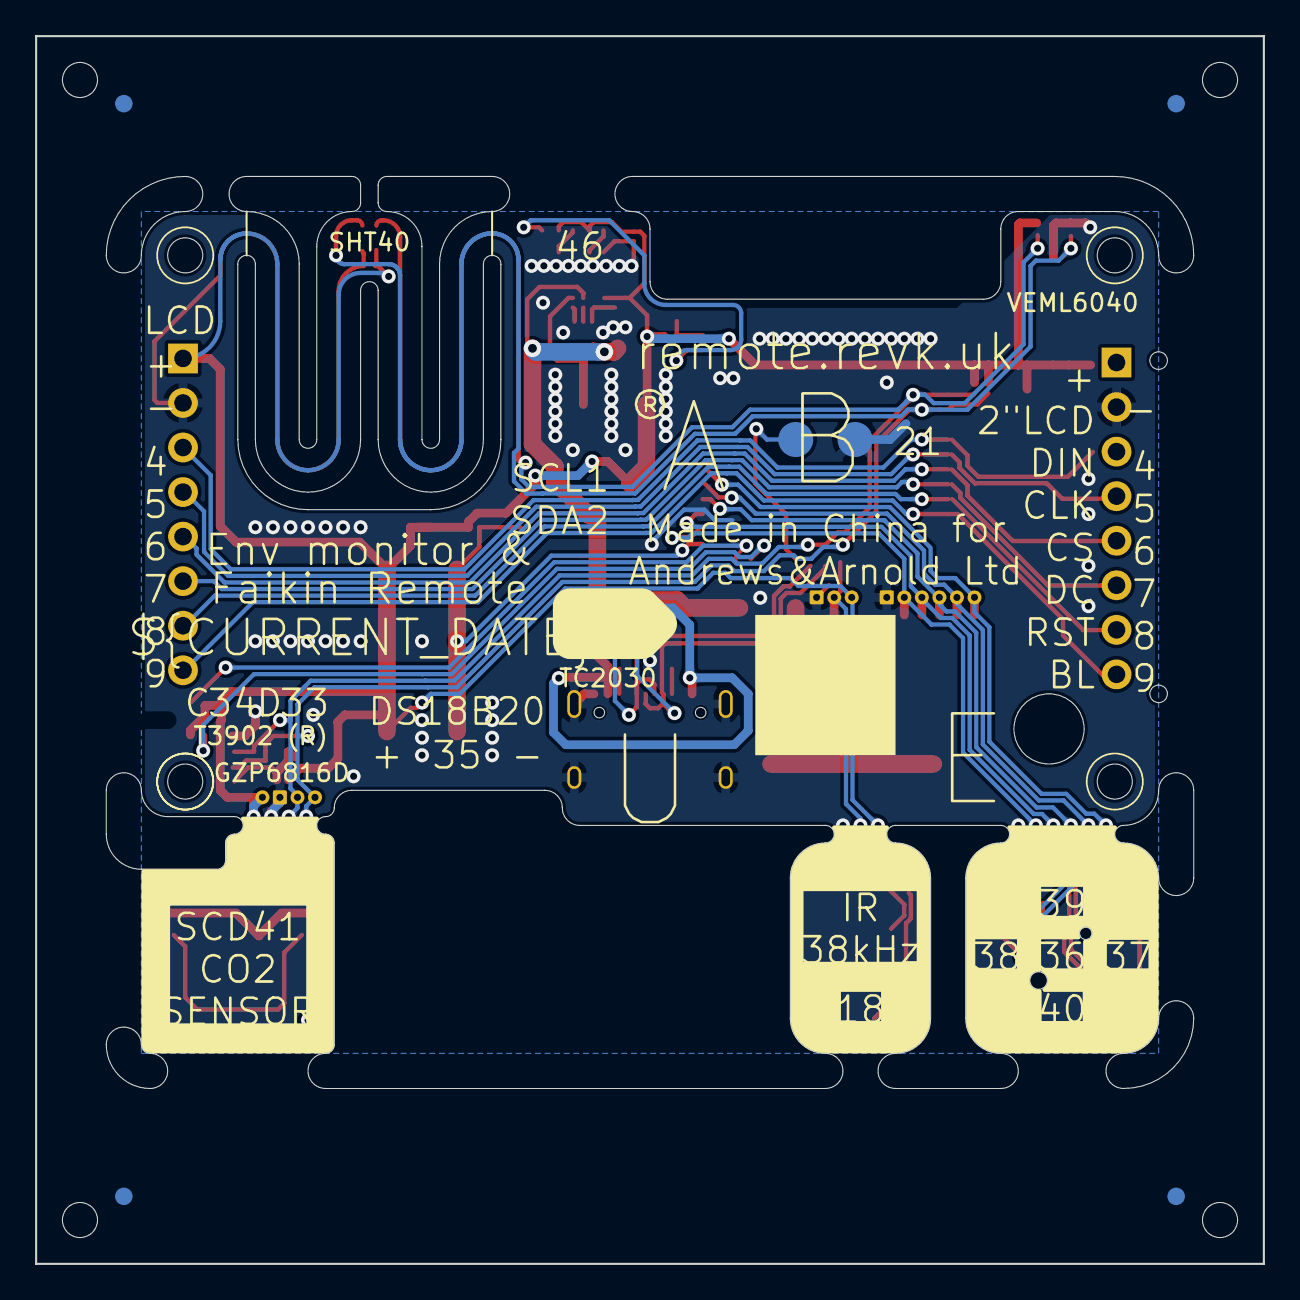
[picture p22: board Remote.kicad_pcb from below]

Board: 2 copper layers, 70.0 x 70.0 mm, 90 parts (3 on the bottom side), 36 nets.
