revk/ESP32-Remote/(commit log)

2025-04-25 Moved PCB here
    [Remote.kicad_pcb, Remote.kicad_sch, Remote.scad, Remote.stl]
2025-04-25 More on fan/radiator mode
2025-04-25 Tidy# Please enter the commit message for your changes. Lines starting
    [Remote.kicad_pcb, bom.csv, positions.csv]
2025-04-26 Library update
    [Remote.kicad_pcb]
2025-04-26 Sensors installed (apart from BLE), and main temp display
2025-04-27 Started on more casework
    [blankplate.scad, lcd2.scad, lcd24.scad]
2025-04-27 More on 3D
    [Remote.scad, Remote.stl, blankplate.scad, blankplate.stl, lcd2.scad, lcd2.stl]
2025-04-28 Button control logic for all settings
2025-04-28 BLE sensor logic
2025-05-02 Manuals, 3d, etc
    [Knob.scad, Knob.stl]
2025-05-03 Power control fixes
2025-05-04 Clean up sensors
2025-05-04 Fix initial 0 temp
    [Remote.c]
2025-05-05 Changed fan/rad control
2025-05-06 New button working mode
    [Knob.scad, Knob.stl]
2025-05-06 New button logic - 4 way not 5
2025-05-07 Avoid radiator fighting cooling
    [Remote.c]
2025-05-08 Updated design
    [Knob.stl, Remote.scad, Remote.stl, RemoteCO2.scad, RemoteCO2.stl]
2025-05-09 Started on new casework
    [Remote-BP.scad, Remote-BP2.scad, RemoteBlind.scad]
2025-05-10 Change to SHT so humidity when no CO2
    [Remote.kicad_pcb, Remote.kicad_sch, bom.csv, designators.csv, positions.csv]
2025-05-10 atest renders
    [Remote-BP2.stl, Remote.kicad_pcb, Remote.scad, Remote.stl, RemoteBlind.scad, RemoteBlind.stl, RemoteCO2.scad, RemoteCO2.stl]
2025-05-10 Latest render
    [Remote.kicad_pcb, Remote.kicad_sch, Remote.scad, Remote.stl, RemoteBlind.scad, RemoteBlind.stl, RemoteCO2.scad, RemoteCO2.stl]
2025-05-11 Rad timer fix
2025-05-11 Target and target revert
    [Remote.c]
2025-05-12 FFS messed up timer logic
2025-05-12 Tidy case design
    [Remote-BP2.scad, Remote.scad, RemoteBlind.scad, RemoteCO2.scad, RemoteNOCO2.scad]
2025-05-12 More LEDs
    [Remote.kicad_pcb, Remote.kicad_sch, bom.csv, designators.csv, positions.csv]
2025-05-13 Latest renders and tweaks
    [Remote-BP2.stl, Remote.kicad_pcb, Remote.scad, Remote.stl, RemoteBlind.scad, RemoteBlind.stl, RemoteCO2.stl, RemoteNOCO2.scad]
2025-05-14 Mic added
    [Remote.kicad_pcb, Remote.kicad_sch, Remote.scad, Remote.stl, RemoteBlind.scad, RemoteBlind.stl, RemoteCO2.scad, RemoteCO2.stl]
2025-05-20 Reworked for connecting switch/SCD41
    [Remote.kicad_pcb, Remote.kicad_sch, Remote.scad, Remote.stl, Remote3partNoBTN.stl, RemoteBlind.scad, RemoteBlind.stl, RemoteCO2.scad]
2025-05-21 New rendere
    [Remote.kicad_pcb, Remote.kicad_sch, Remote.scad, Remote.stl, RemoteBlind.scad, RemoteBlind.stl, RemoteCO2.scad, RemoteCO2.stl]
2025-05-21 Tidy rendering
    [Remote.kicad_pcb, Remote.scad, Remote.stl, RemoteBlind.scad, RemoteBlind.stl, RemoteCO2.scad, RemoteCO2.stl, RemoteNOCO2.scad]
2025-05-21 Clean up BOM
    [Remote.kicad_pcb, Remote.kicad_sch, bom.csv]
2025-05-25 Better clearance on USB lead
    [Remote.kicad_pcb, positions.csv]
2025-05-26 Default fan
2025-05-31 Re render/case
    [Remote.kicad_sch, Remote.scad, Remote.stl, RemoteBlind.scad, RemoteBlind.stl, RemoteCO2.scad, RemoteCO2.stl, RemoteNOCO2.scad]
2025-05-31 Moved around
    [Remote.kicad_pcb, Remote.scad, Remote.stl, RemoteBlind.scad, RemoteBlind.stl, RemoteCO2.scad, RemoteCO2.stl, RemoteNOCO2.scad]
2025-06-02 Case update
    [Remote.kicad_pcb, Remote.scad, Remote.stl, RemoteBlind.scad, RemoteBlind.stl, RemoteCO2.scad, RemoteCO2.stl, RemoteNOCO2.scad]
2025-06-02 Case improvement - but needs more work
    [Remote.scad, Remote.stl, RemoteBlind.scad, RemoteBlind.stl, RemoteCO2.scad, RemoteCO2.stl, RemoteNOCO2.scad, RemoteNOCO2.stl]
2025-06-02 Much tidy
    [RemoteCO2.scad, RemoteCO2.stl]
2025-06-03 New layout - IR back to sensible place
    [Remote.kicad_pcb, Remote.kicad_sch, Remote.scad, Remote.stl, RemoteBlind.scad, RemoteBlind.stl, RemoteCO2.scad, RemoteCO2.stl]
2025-06-07 Moved mic
    [Remote.kicad_pcb, Remote.kicad_sch, bom.csv, positions.csv]
2025-06-12 More cases
    [Remote---.scad, Remote---.stl, Remote--B.scad, Remote--B.stl, Remote-I-.scad, Remote-I-.stl, Remote-IB.scad, Remote-IB.stl]
2025-07-09 Latest renders
    [Remote.kicad_pcb, Remote.kicad_sch, bom.csv]
2025-07-17 Update reg
    [Remote.kicad_pcb, Remote.kicad_sch, bom.csv]
2025-07-26 Clearing inductror
    [Remote.kicad_pcb, Remote.kicad_sch, positions.csv]
2025-08-09 Fix merge
    [Remote.kicad_pcb, Remote.kicad_sch]
2025-08-09 New renders and case
    [Remote---.scad, Remote---.stl, Remote--B.scad, Remote--B.stl, Remote-I-.scad, Remote-I-.stl, Remote-IB.scad, Remote-IB.stl]
2025-08-11 New render
    [Remote---.scad, Remote---.stl, Remote--B.scad, Remote--B.stl, Remote-I-.scad, Remote-I-.stl, Remote-IB.scad, Remote-IB.stl]
2025-08-13 Fix BOM/pos
    [Remote.kicad_pcb, bom.csv, positions.csv]
2025-08-14 Re render and new knob
    [Knob.scad, Knob.stl, Knob2.stl, Remote---B.scad, Remote---B.stl, Remote---T.scad, Remote---T.stl, Remote--BB.scad]
2025-08-15 LED controls for triple LED boards
2025-08-16 new case
    [RemoteBlind---B.scad, RemoteBlind---B.stl, RemoteBlind---T.scad, RemoteBlind---T.stl, RemoteBlindB.scad, RemoteBlindB.stl, RemoteBlindT.stl]
2025-08-17 Cleaner casework
    [Remote---.scad, Remote---B.scad, Remote---B.stl, Remote---T.scad, Remote---T.stl, Remote--BB.scad, Remote--BB.stl, Remote--BT.scad]
2025-08-18 A *lot* of case options
    [Remote------.scad, Remote------.stl, Remote-----B.scad, Remote-----B.stl, Remote----I-.scad, Remote----I-.stl, Remote----IB.scad, Remote----IB.stl]
2025-08-18 Case fix (base)
    [Remote------.scad, Remote-----B.scad, Remote----I-.scad, Remote----IB.scad, Remote---C--.scad, Remote---C-B.scad, Remote---CI-.scad, Remote---CIB.scad]
2025-08-22 dark setting green LEDs off
2025-08-26 README and new render
    [Remote--DC--.stl, Remote--DC-B.stl, Remote--DCI-.stl, Remote--DCIB.stl, Remote-Base.stl, Remote-P----.stl, Remote-P---B.stl, Remote-P--I-.stl]
2025-10-10 New LED
    [Remote.kicad_pcb, Remote.kicad_sch, bom.csv, positions.csv]
2026-01-02 Tweaks, but cases look wrong
    [Remote------.scad, Remote------.stl, Remote-----B.scad, Remote-----B.stl, Remote----I-.scad, Remote----I-.stl, Remote----IB.scad, Remote----IB.stl]
2026-01-02 Still buggered
    [Remote------.scad, Remote------.stl, Remote-----B.scad, Remote-----B.stl, Remote----I-.scad, Remote----I-.stl, Remote----IB.scad, Remote----IB.stl]
2026-01-03 Improved case design
    [Remote------.scad, Remote------.stl, Remote-----B.scad, Remote-----B.stl, Remote----I-.scad, Remote----I-.stl, Remote----IB.scad, Remote----IB.stl]
2026-01-05 New LED lib
2026-02-03 Fan control fix
